unbleavabl/deck-macropad/macropad/LINKS.md

# Links

These links stay the same through future updates: republishing reuses the same URL,
so reload the page to see the newest version. Both are private to the owner's
claude.ai account until shared from the page's Share menu.

| What | Link | Source in this repo |
|---|---|---|
| Wiring diagram (interactive: lid, plate, numbered harness) | https://claude.ai/artifact/4pcYRyfMjdKxRtB2dDA4gZ | `wiring/wiring.html`, built by `wiring/build.py` |
| Build guide (step by step, editable doc) | https://claude.ai/code/artifact/070e5841-1c04-4409-ae30-39a42349cde0 | exported as `build-guide.pdf` |

When asking for an update in a new conversation, pass the link above so the same
page is updated instead of a new one being created.
