unbleavabl/deck-macropad/macropad/case/stickers/stickers.pdf

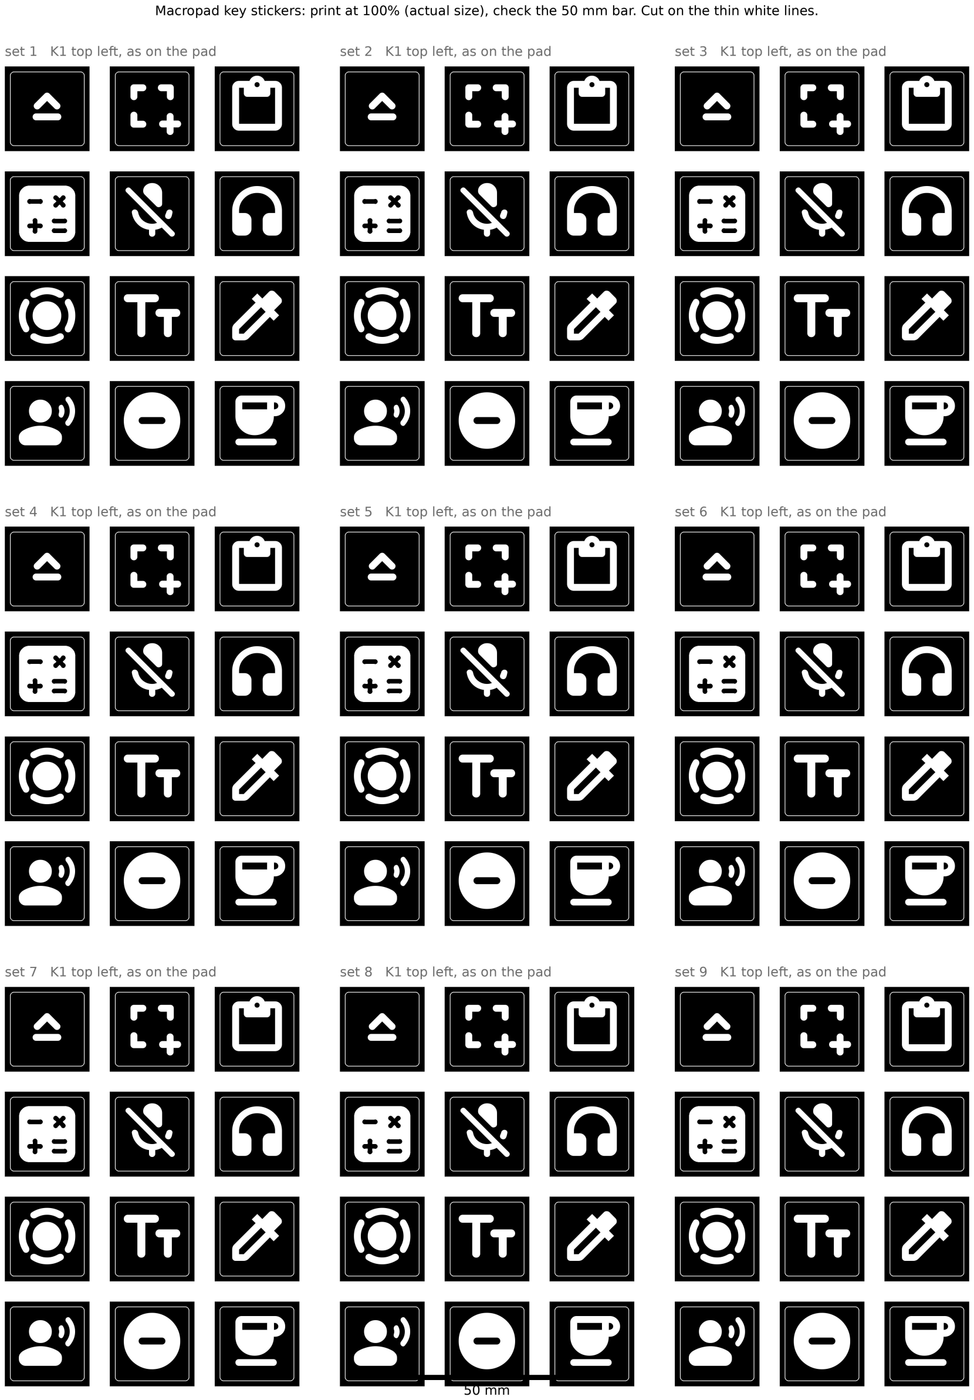
[picture p6: page 1]
