unbleavabl/deck-macropad/macropad/case/stickers/stickers_clear.pdf

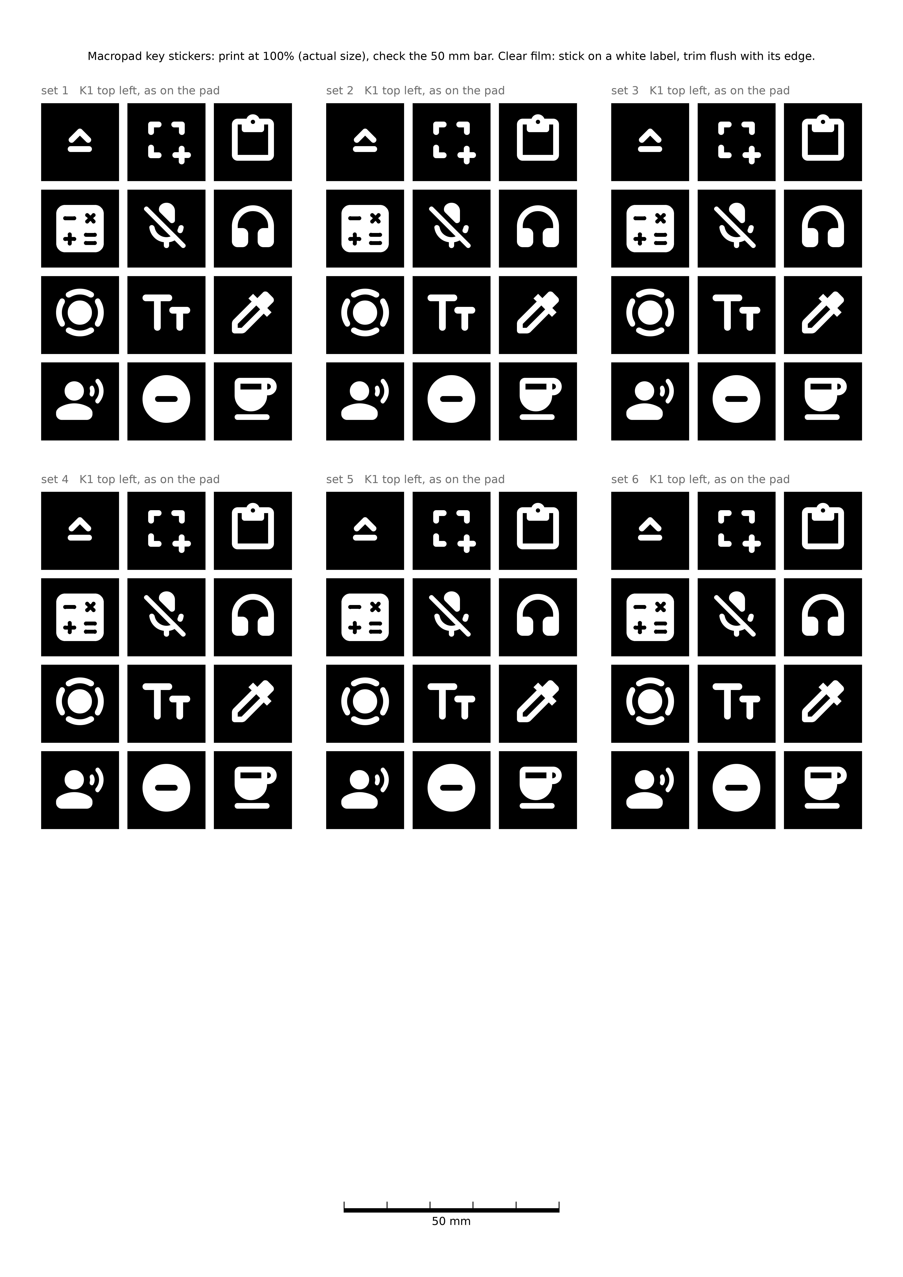
[picture p7: page 1]
