unbleavabl/deck-macropad/macropad/case/preview/combs.png

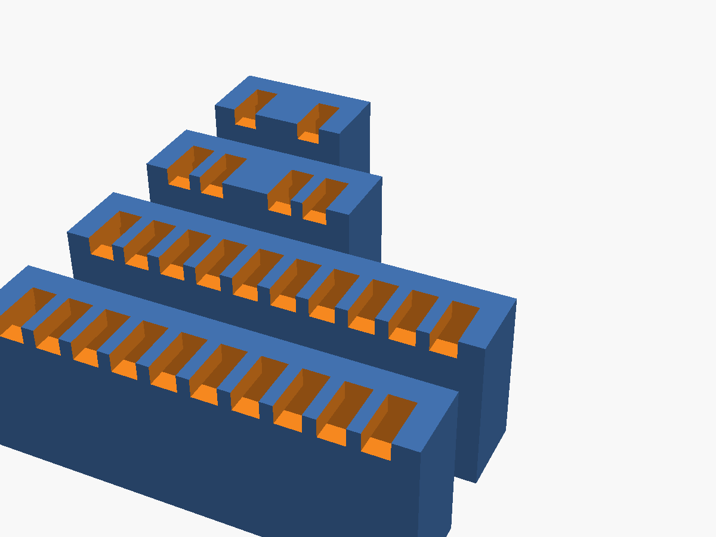
macropad/case/preview/combs.png
