unbleavabl/deck-macropad/macropad/case/preview/deck.png

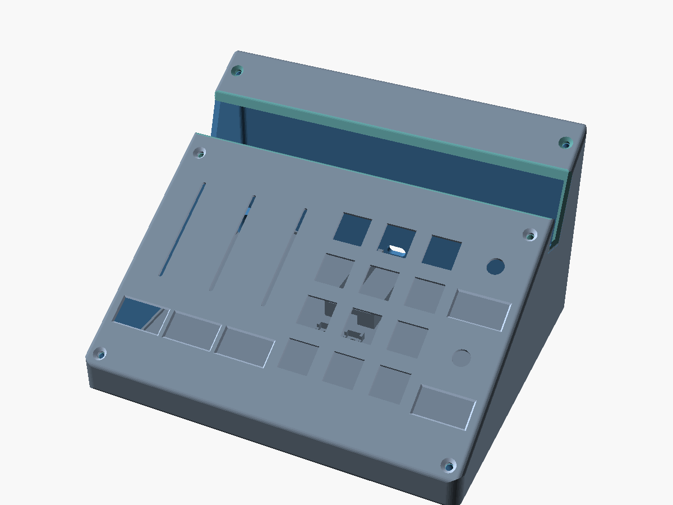
macropad/case/preview/deck.png
