unbleavabl/deck-macropad/macropad/case/preview/deck_back.png

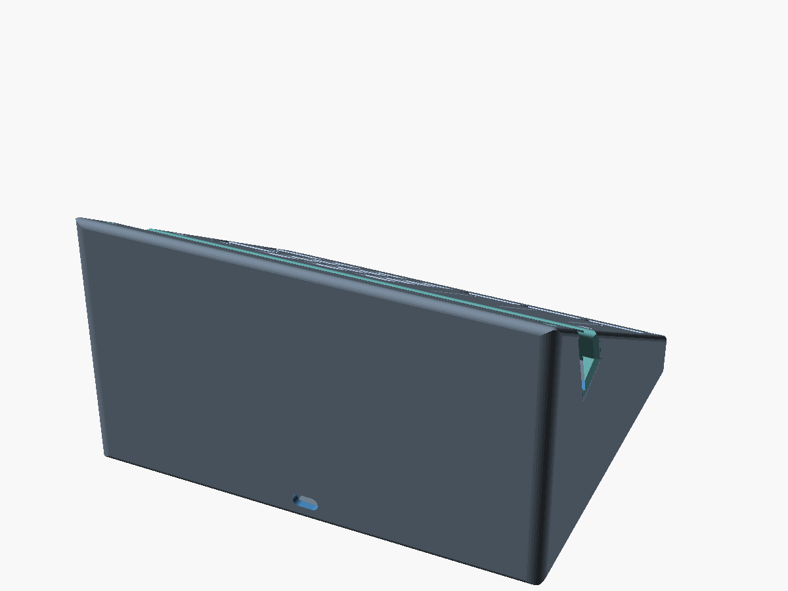
macropad/case/preview/deck_back.png
