unbleavabl/deck-macropad/macropad/case/preview/glue_labels.png

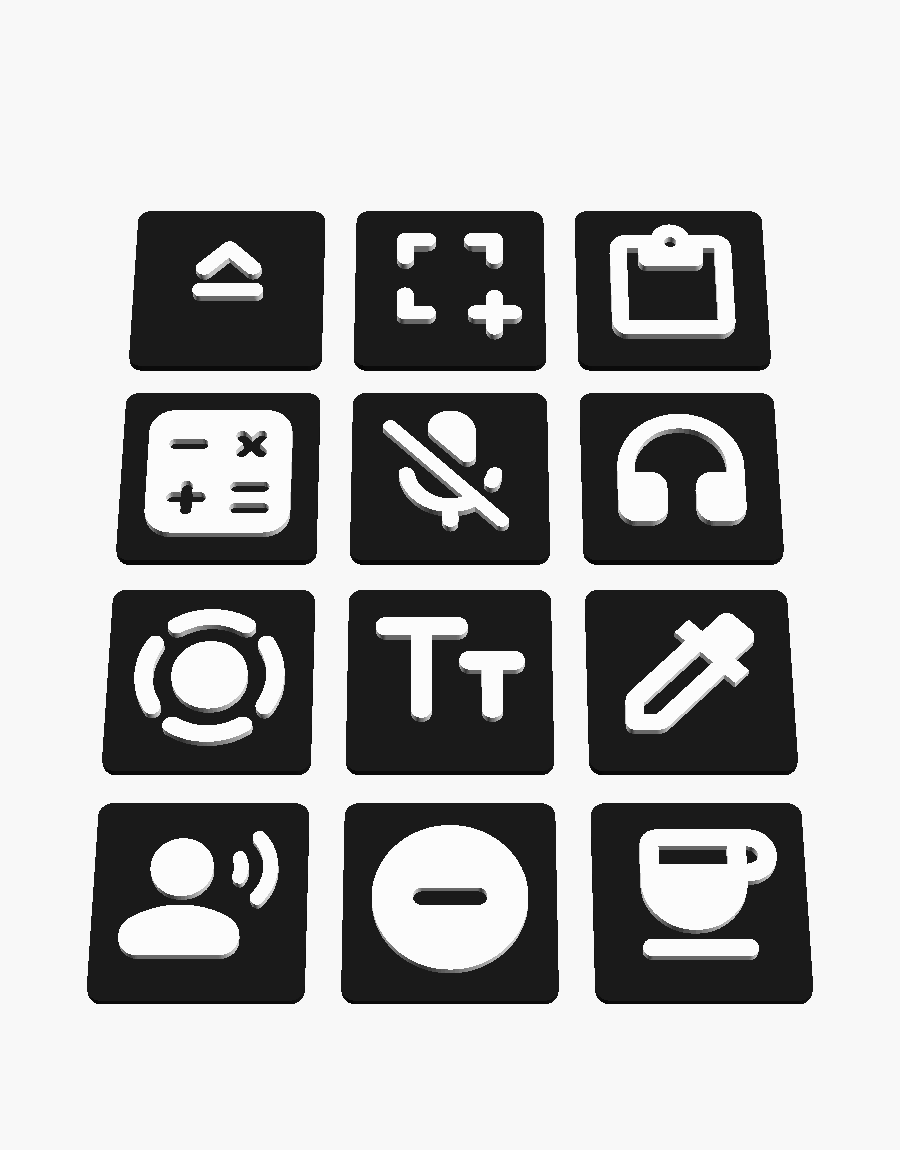
macropad/case/preview/glue_labels.png
