unbleavabl/deck-macropad/macropad/case/preview/keycaps_angle.png

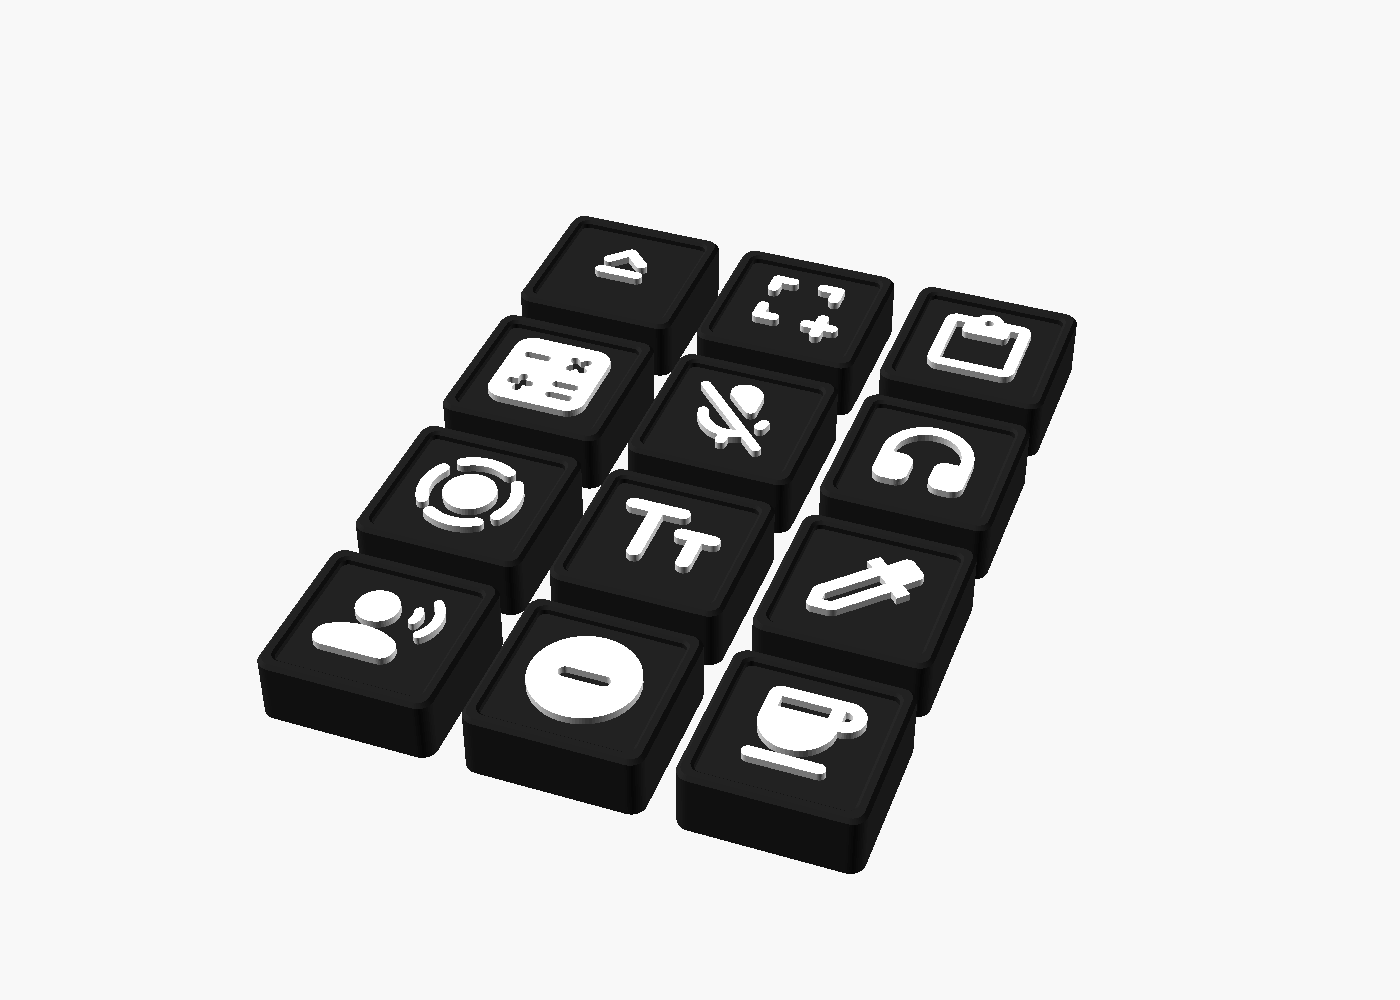
macropad/case/preview/keycaps_angle.png
