unbleavabl/deck-macropad/macropad/case/stickers/stickers.png

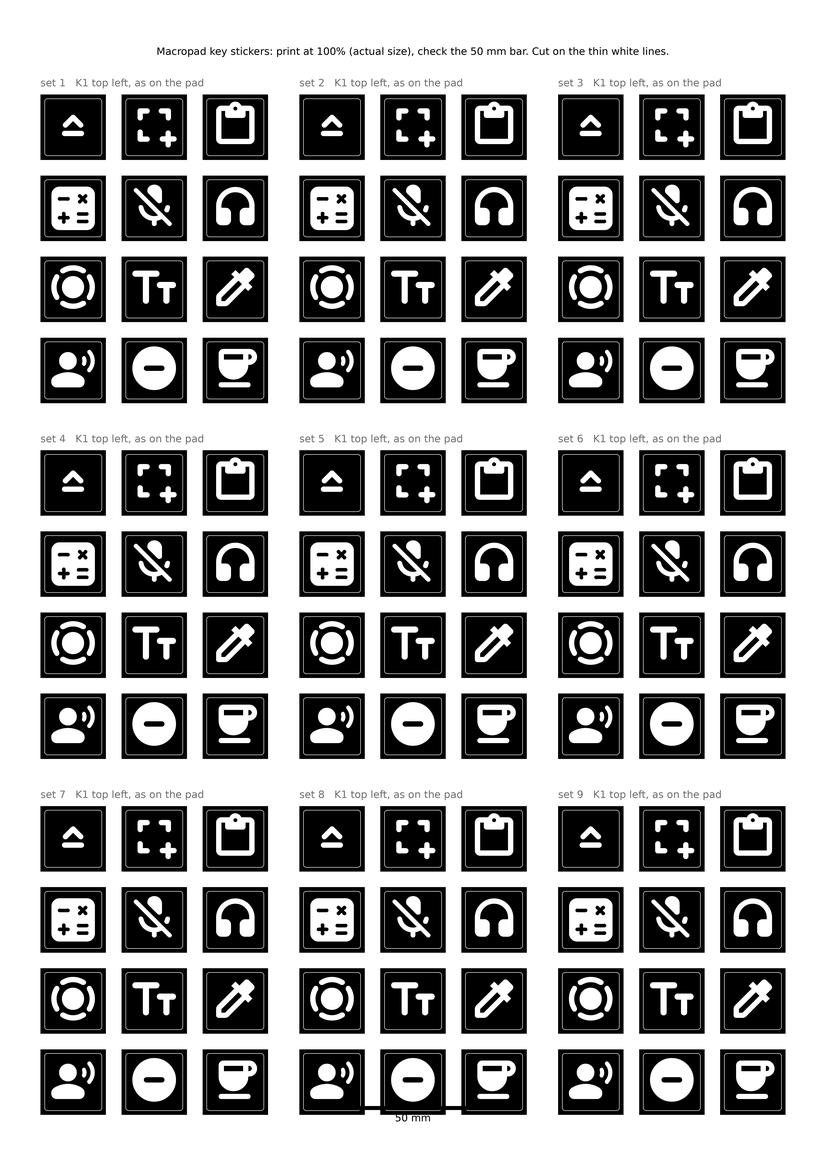
macropad/case/stickers/stickers.png
