unbleavabl/deck-macropad/macropad/case/stickers/text_black.png

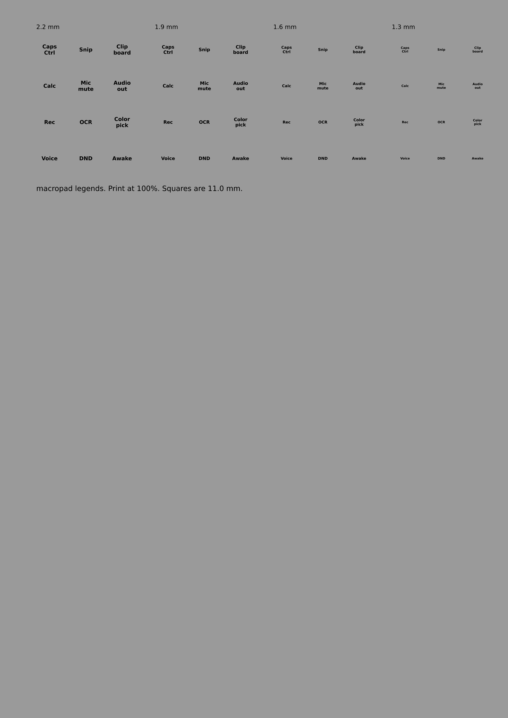
macropad/case/stickers/text_black.png
