unbleavabl/deck-macropad/macropad/case/stickers/text_yellow.png

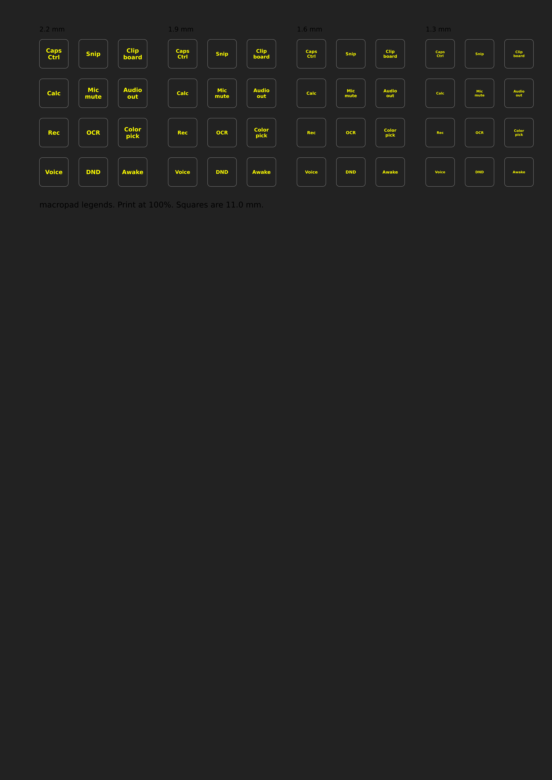
macropad/case/stickers/text_yellow.png
