unbleavabl/deck-macropad/macropad/firmware/layouts-mock-2.png

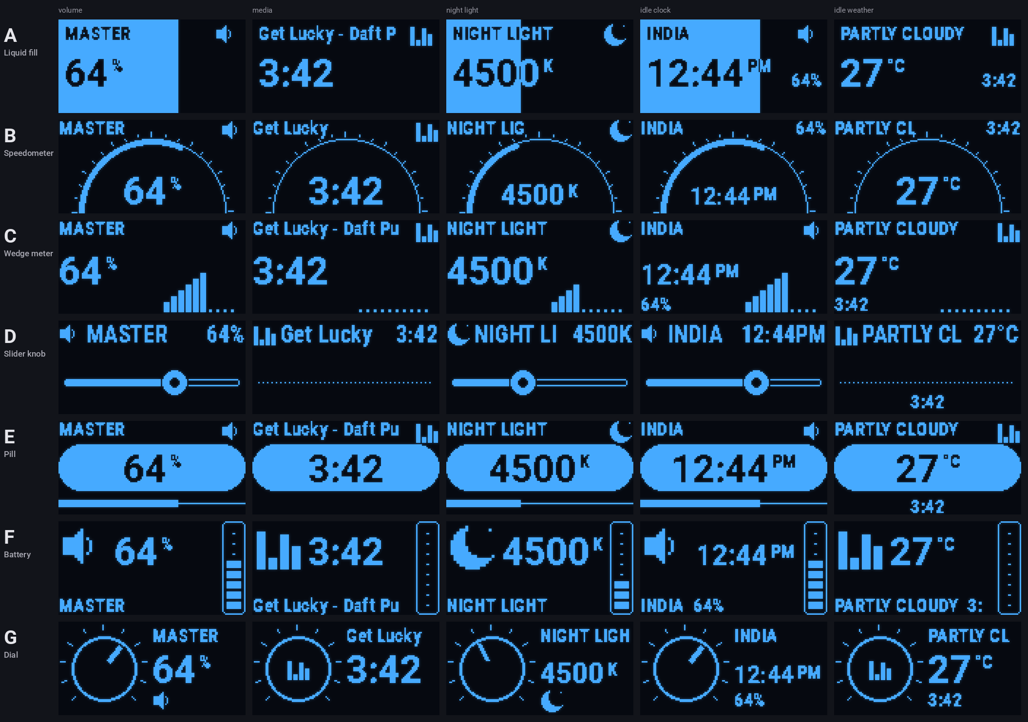
macropad/firmware/layouts-mock-2.png
