unbleavabl/deck-macropad/macropad/firmware/layouts-mock-3.png

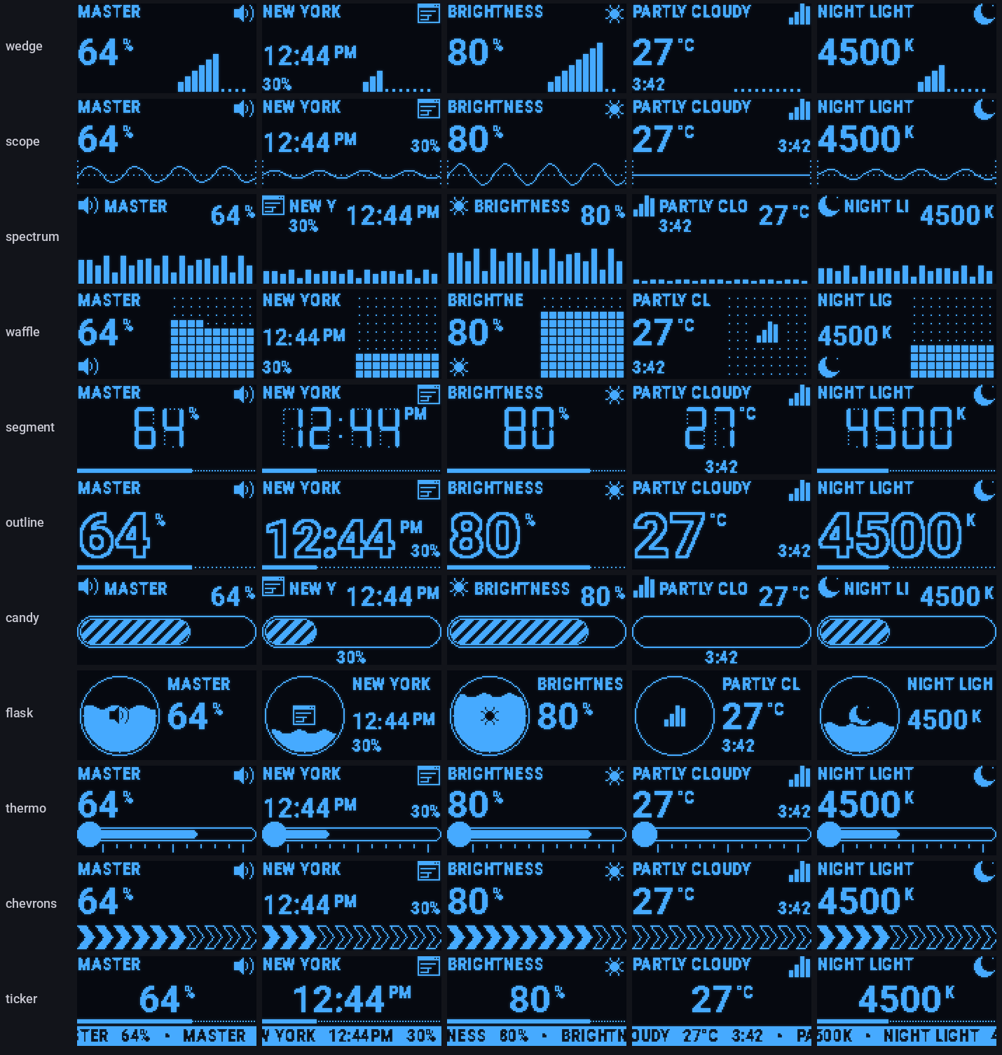
macropad/firmware/layouts-mock-3.png
