unbleavabl/deck-macropad/macropad/firmware/layouts-mock-4.png

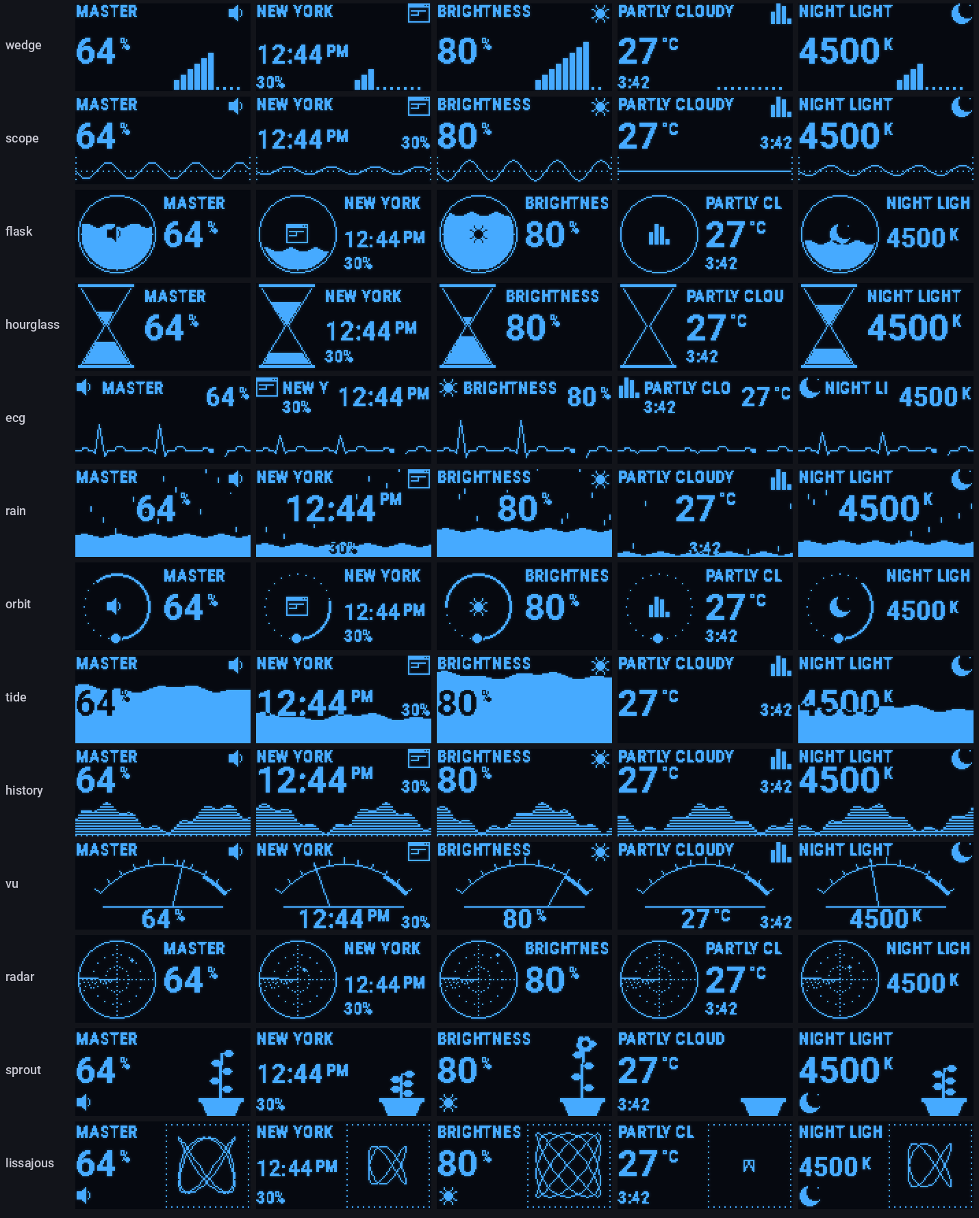
macropad/firmware/layouts-mock-4.png
