unbleavabl/deck-macropad/macropad/firmware/layouts-mock.png

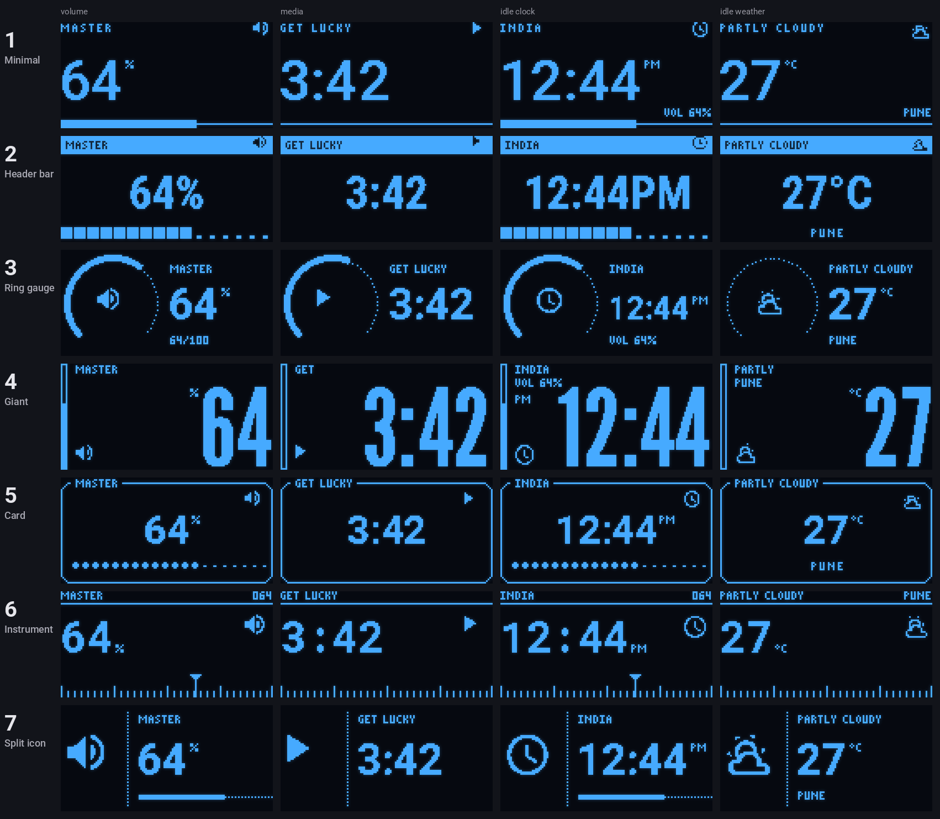
macropad/firmware/layouts-mock.png
