unbleavabl/deck-macropad/macropad/case/preview/parts.png

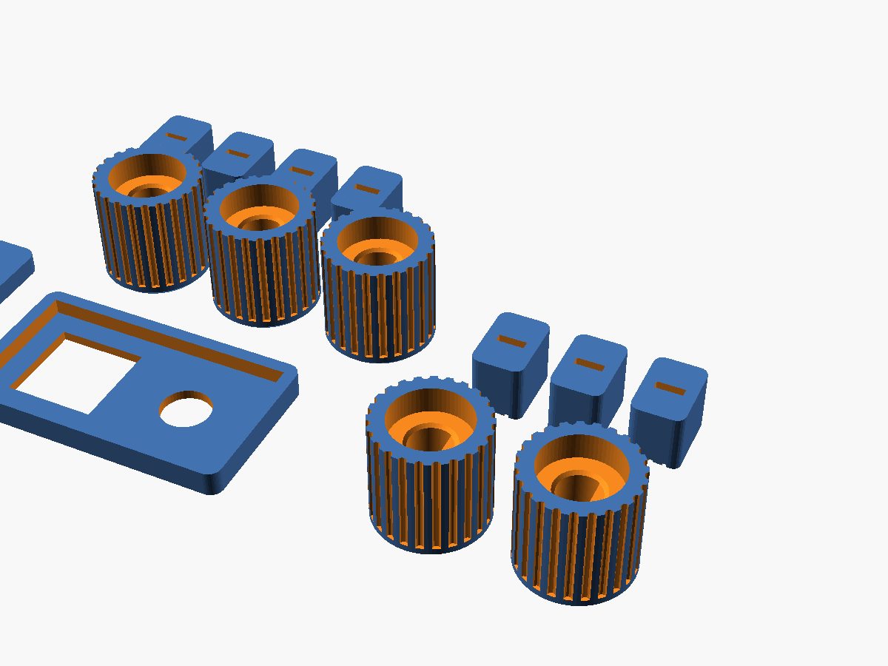
macropad/case/preview/parts.png
