unbleavabl/deck-macropad/macropad/case/3mf/keycaps.3mf

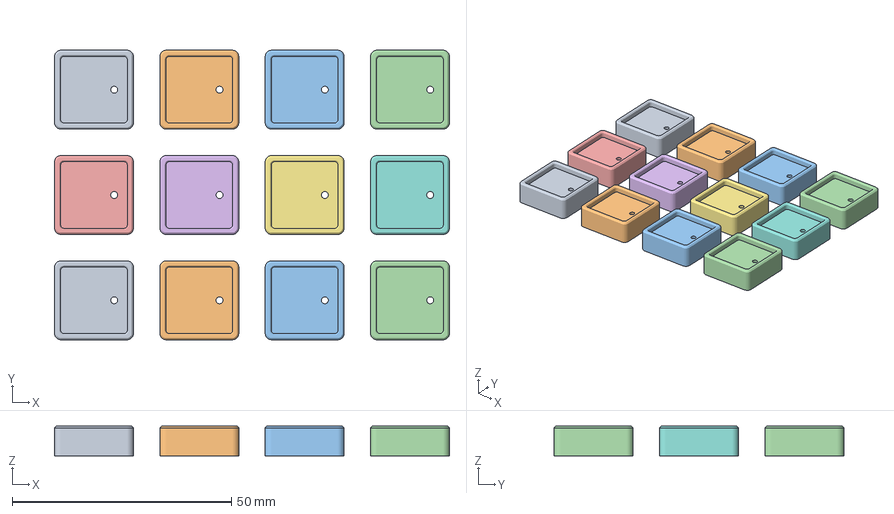
[picture p21: CAD file, 2026-10-14]
macropad/case/3mf/keycaps.3mf
90.0 x 66.0 x 6.80 mm
keycap 1
keycap 2
keycap 3
keycap 4
keycap 5
keycap 6
keycap 7
keycap 8
keycap 9
keycap 10
keycap 11
keycap 12
