unbleavabl/deck-macropad/macropad/case/stl/combs/comb_A.stl

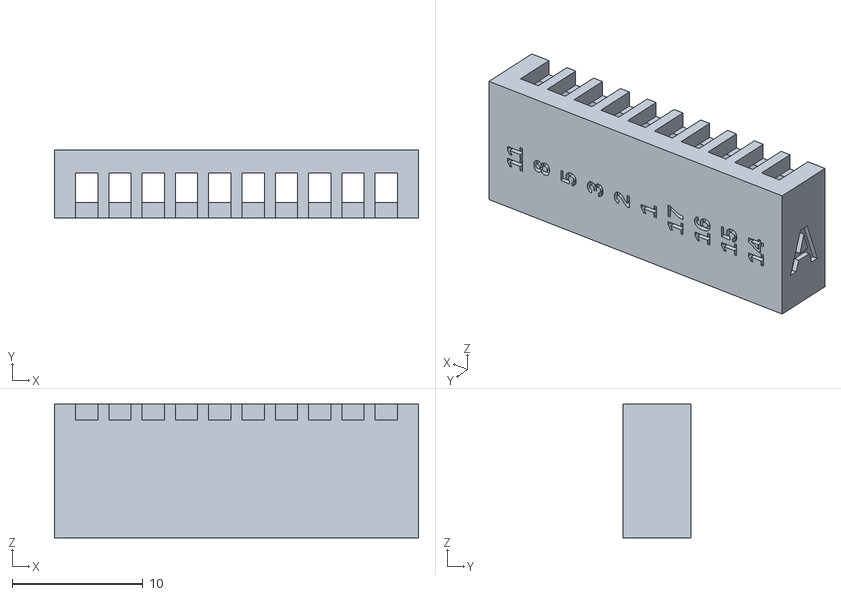
[picture p22: CAD file, 2026-10-14]
macropad/case/stl/combs/comb_A.stl
27.8 x 5.20 x 10.2
