unbleavabl/deck-macropad/macropad/case/stl/deck/deck_frame.stl

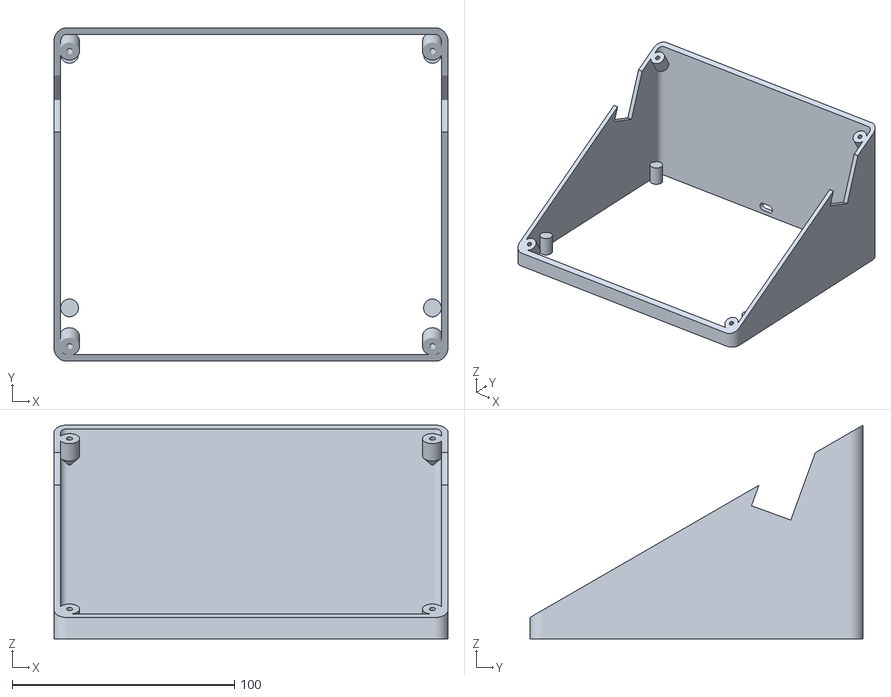
[picture p23: CAD file, 2026-10-14]
macropad/case/stl/deck/deck_frame.stl
177.2 x 150.0 x 96.1
