unbleavabl/deck-macropad/macropad/case/stl/fit-tests/fit_switch_encoder.stl

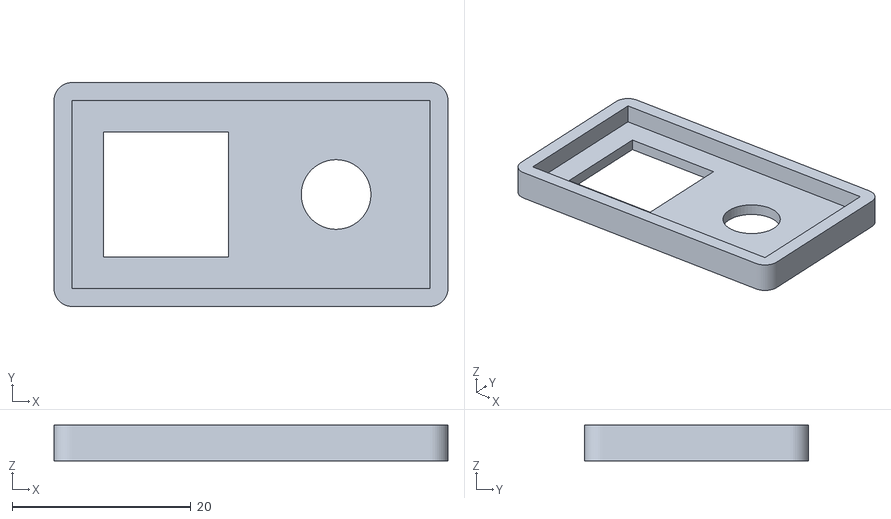
[picture p24: CAD file, 2026-10-14]
macropad/case/stl/fit-tests/fit_switch_encoder.stl
44.1 x 25.1 x 4.00
