unbleavabl/deck-macropad/macropad/case/stl/glue/glue_body.stl

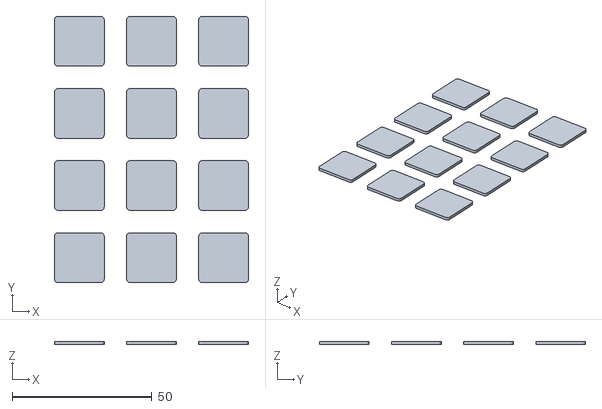
[picture p25: CAD file, 2026-10-14]
macropad/case/stl/glue/glue_body.stl
69.4 x 95.2 x 1.20
