unbleavabl/deck-macropad/macropad/case/stl/keycaps/keycap.stl

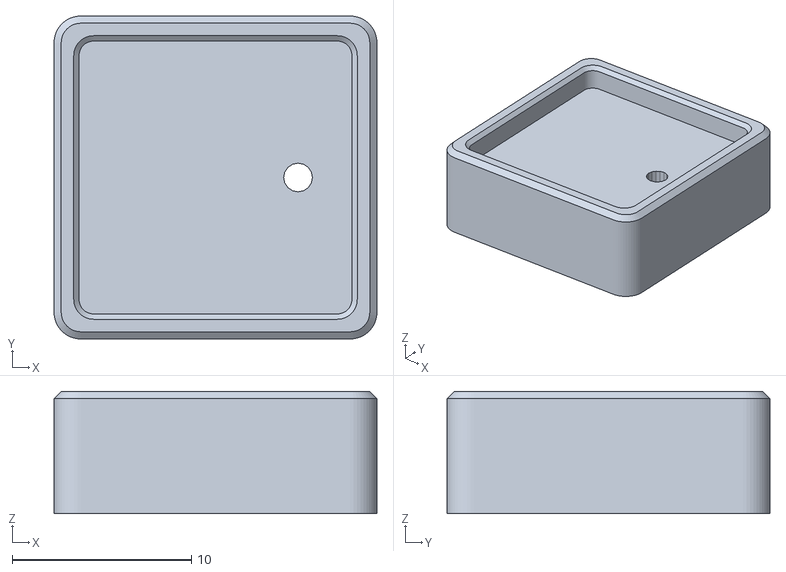
[picture p26: CAD file, 2026-10-14]
macropad/case/stl/keycaps/keycap.stl
18.0 x 18.0 x 6.80
