unbleavabl/deck-macropad/macropad/case/stl/knobs-caps/knob.stl

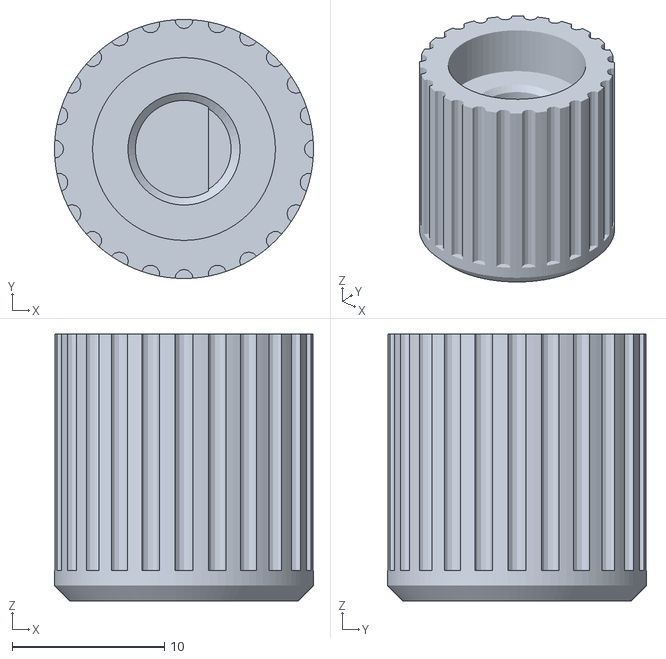
[picture p27: CAD file, 2026-10-14]
macropad/case/stl/knobs-caps/knob.stl
17.0 x 17.0 x 17.5
