unbleavabl/deck-macropad/macropad/case/3mf/fit_keycap_caps.3mf

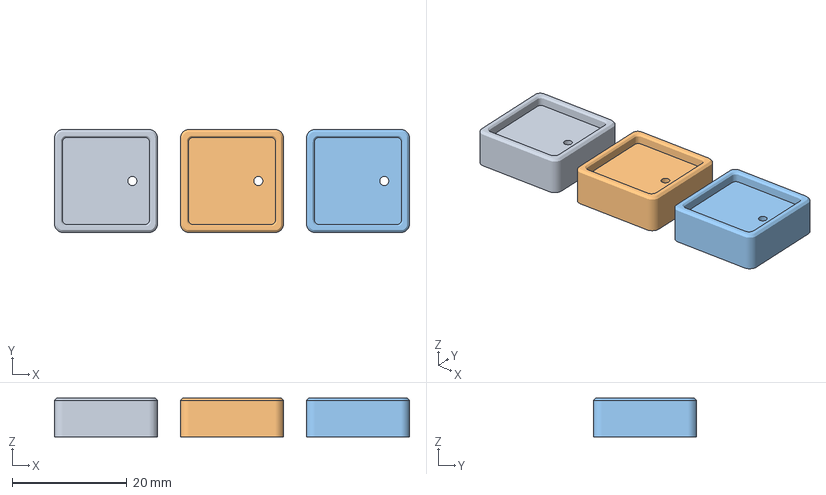
[picture p28: CAD file, 2026-10-14]
macropad/case/3mf/fit_keycap_caps.3mf
62.0 x 18.0 x 6.80 mm
cap 1 dot cross 4.0 x 1.2
cap 2 dots cross 4.1 x 1.3
cap 3 dots cross 4.2 x 1.4
