unbleavabl/deck-macropad/macropad/case/stl/combs/comb_C.stl

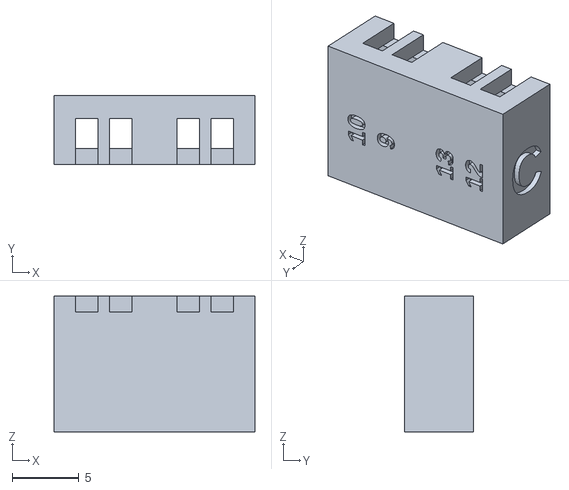
[picture p29: CAD file, 2026-10-14]
macropad/case/stl/combs/comb_C.stl
15.1 x 5.20 x 10.2
