unbleavabl/deck-macropad/macropad/case/stl/deck/deck_plate.stl

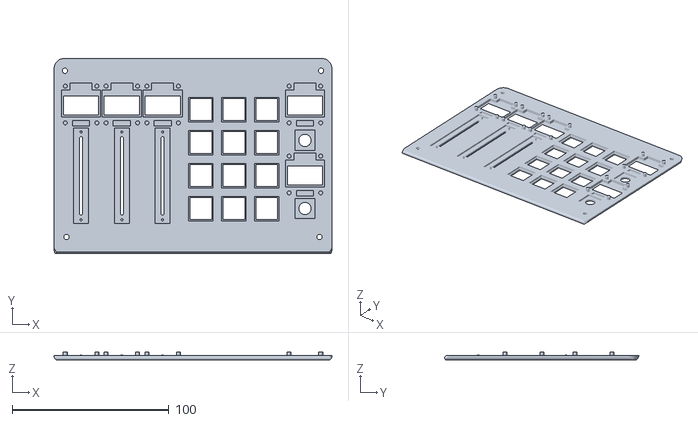
[picture p30: CAD file, 2026-10-14]
macropad/case/stl/deck/deck_plate.stl
177.2 x 124.1 x 5.38
