unbleavabl/deck-macropad/macropad/case/stl/fit-tests/fit_keycap_labels.stl

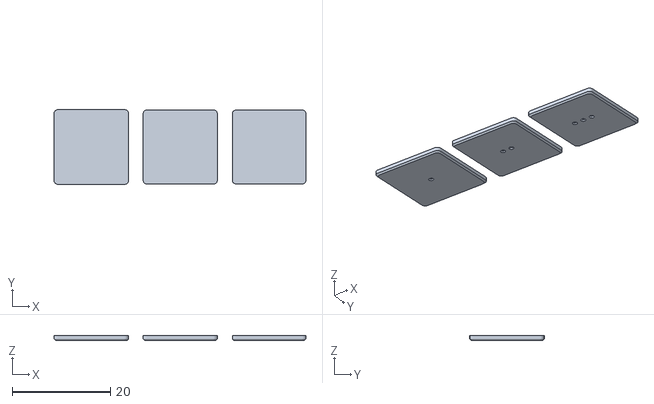
[picture p31: CAD file, 2026-10-14]
macropad/case/stl/fit-tests/fit_keycap_labels.stl
51.3 x 15.2 x 1.00
