unbleavabl/deck-macropad/macropad/case/stl/glue/glue_legend.stl

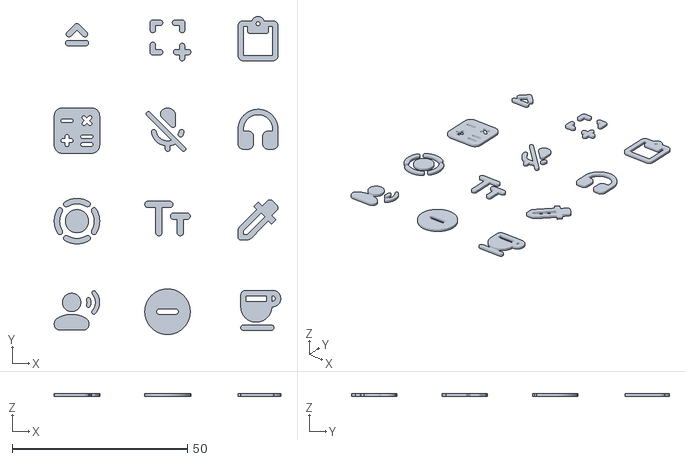
[picture p32: CAD file, 2026-10-14]
macropad/case/stl/glue/glue_legend.stl
64.6 x 90.6 x 0.8
