unbleavabl/deck-macropad/macropad/case/stl/keycaps/label_legend.stl

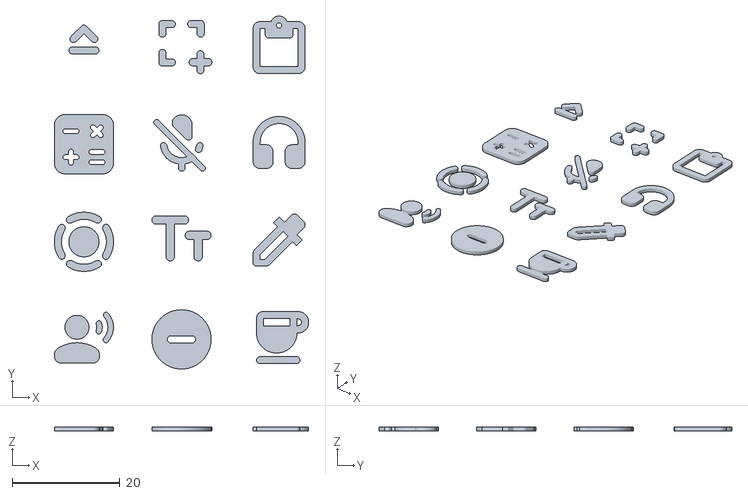
[picture p33: CAD file, 2026-10-14]
macropad/case/stl/keycaps/label_legend.stl
47.2 x 65.5 x 0.8
