unbleavabl/deck-macropad/macropad/case/stl/knobs-caps/enc_spacer.stl

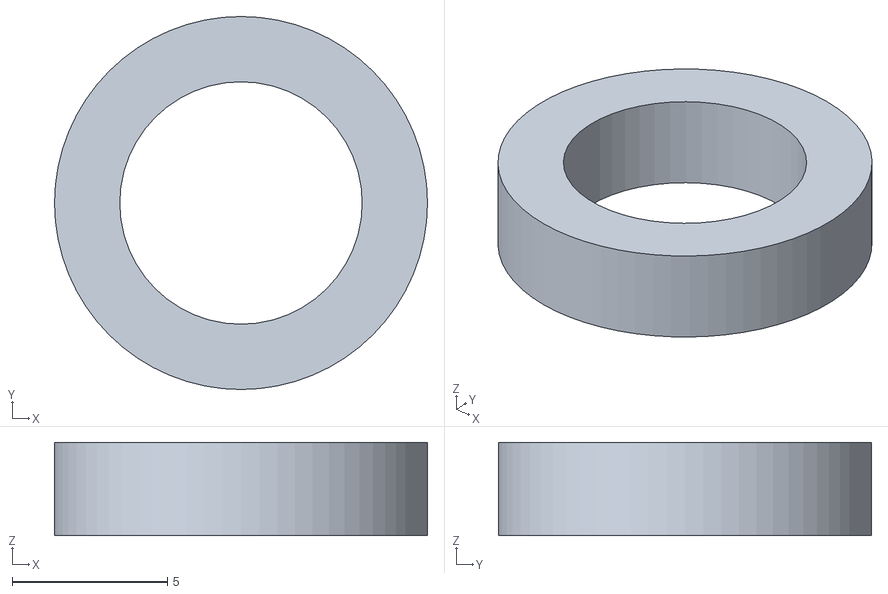
[picture p34: CAD file, 2026-10-14]
macropad/case/stl/knobs-caps/enc_spacer.stl
12.0 x 12.0 x 3.00
