unbleavabl/deck-macropad/macropad/case/3mf/labels.3mf

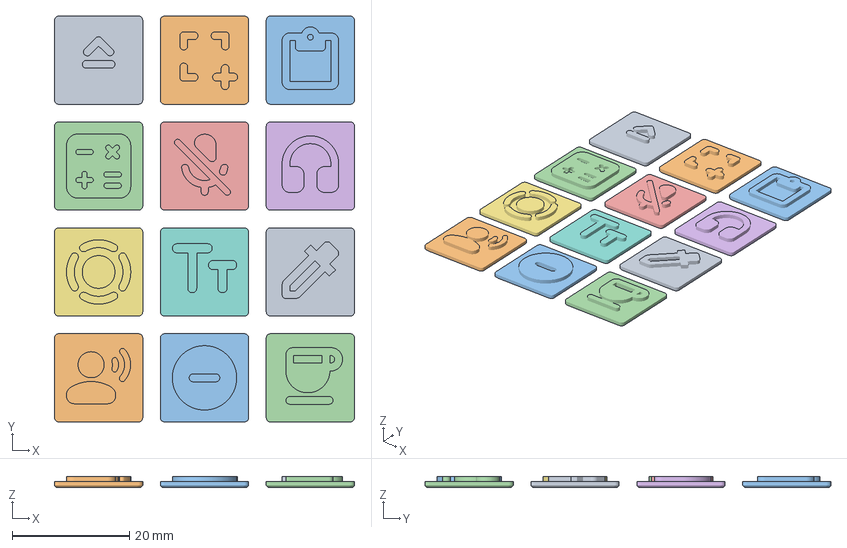
[picture p35: CAD file, 2026-10-14]
macropad/case/3mf/labels.3mf
51.3 x 69.4 x 1.80 mm
K1 label
K2 label
K3 label
K4 label
K5 label
K6 label
K7 label
K8 label
K9 label
K10 label
K11 label
K12 label
