unbleavabl/deck-macropad/macropad/case/stl/deck/deck_dock.stl

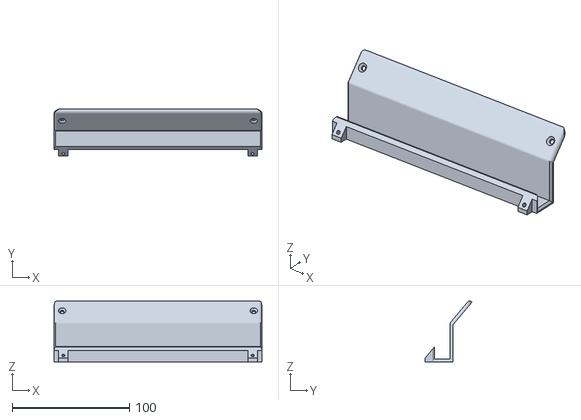
[picture p36: CAD file, 2026-10-14]
macropad/case/stl/deck/deck_dock.stl
177.2 x 40.1 x 51.9
