unbleavabl/deck-macropad/macropad/case/stl/fit-tests/fit_knob.stl

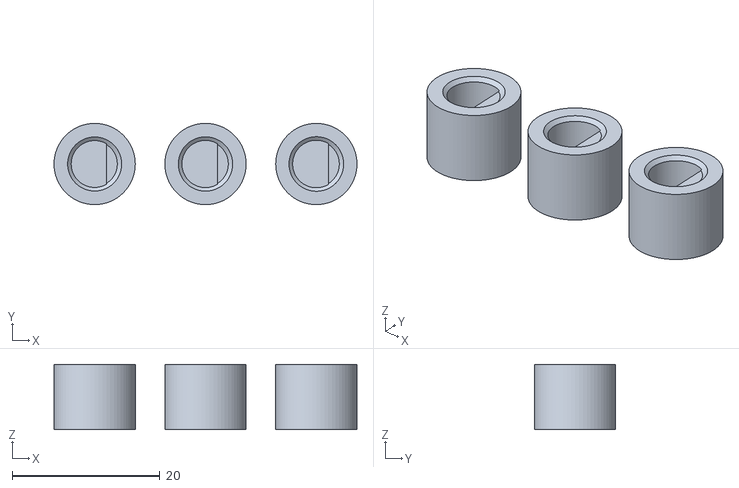
[picture p37: CAD file, 2026-10-14]
macropad/case/stl/fit-tests/fit_knob.stl
41.0 x 11.0 x 8.80
