unbleavabl/deck-macropad/macropad/case/stl/keycaps/label_body.stl

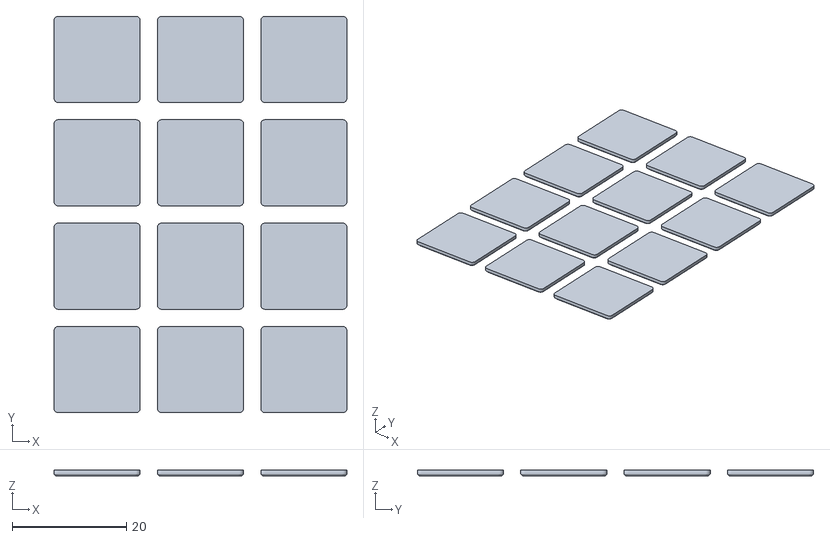
[picture p38: CAD file, 2026-10-14]
macropad/case/stl/keycaps/label_body.stl
51.3 x 69.4 x 1.00
