unbleavabl/deck-macropad/macropad/case/stl/knobs-caps/fader_cap.stl

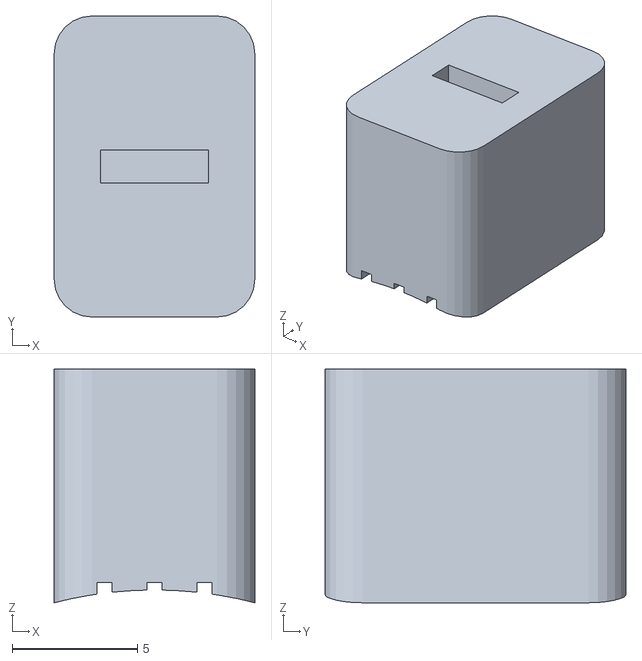
[picture p39: CAD file, 2026-10-14]
macropad/case/stl/knobs-caps/fader_cap.stl
8.00 x 12.0 x 9.31
