unbleavabl/deck-macropad/macropad/case/3mf/fit_keycap_labels.3mf

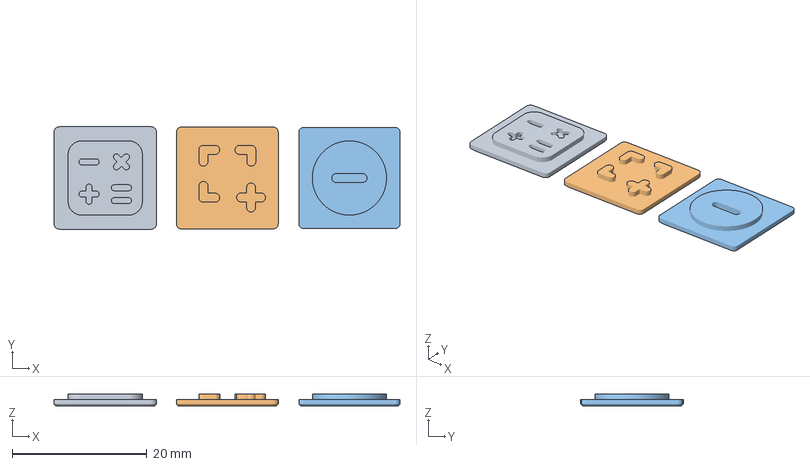
[picture p40: CAD file, 2026-10-14]
macropad/case/3mf/fit_keycap_labels.3mf
51.3 x 15.2 x 1.80 mm
label 1 dot clearance 0.00
label 2 dots clearance 0.05
label 3 dots clearance 0.10
