unbleavabl/deck-macropad/macropad/case/stl/combs/fit_comb.stl

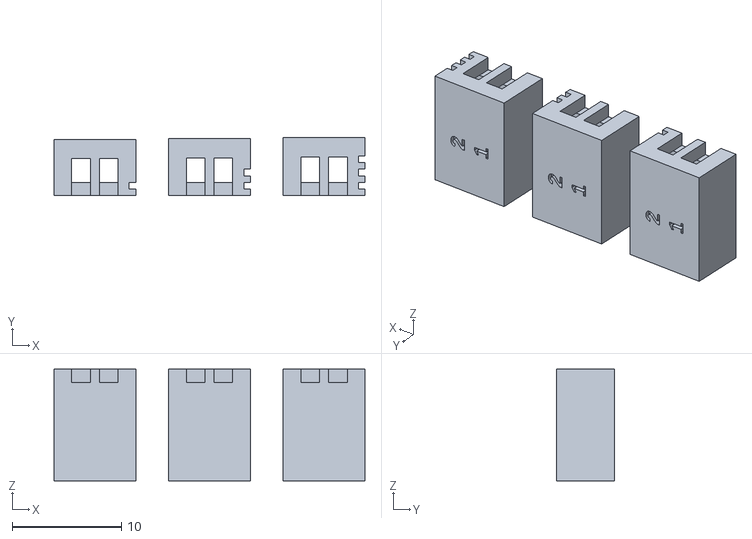
[picture p41: CAD file, 2026-10-14]
macropad/case/stl/combs/fit_comb.stl
28.4 x 5.30 x 10.2
