unbleavabl/deck-macropad/macropad/case/stl/deck/deck_lid.stl

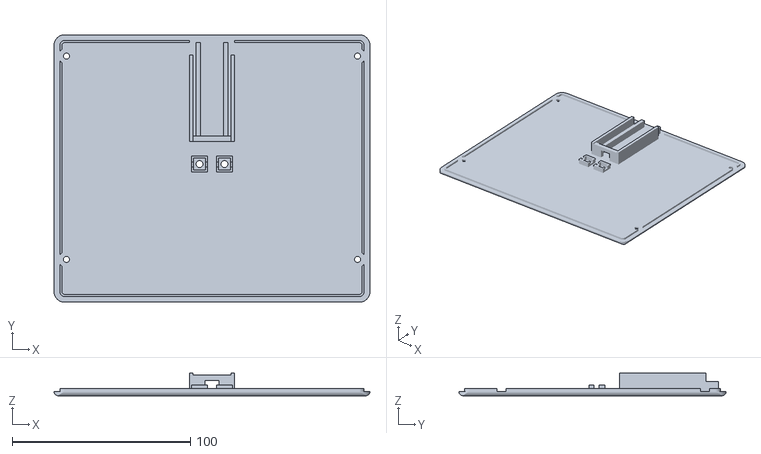
[picture p42: CAD file, 2026-10-14]
macropad/case/stl/deck/deck_lid.stl
177.2 x 150.0 x 12.7
