unbleavabl/deck-macropad/macropad/case/stl/fit-tests/fit_knob_caps.stl

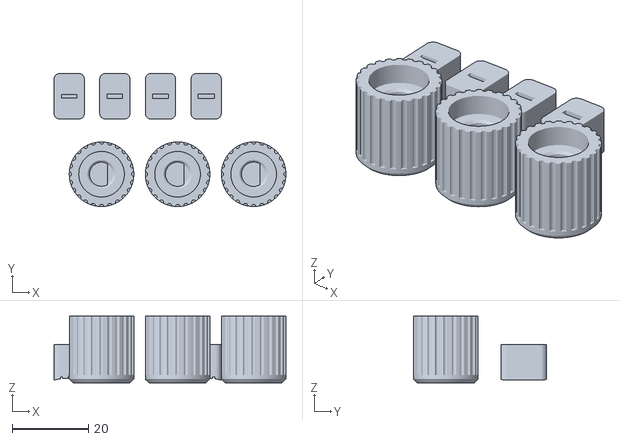
[picture p43: CAD file, 2026-10-14]
macropad/case/stl/fit-tests/fit_knob_caps.stl
61.0 x 35.0 x 17.5
