unbleavabl/deck-macropad/macropad/case/stl/keycaps/label_blank.stl

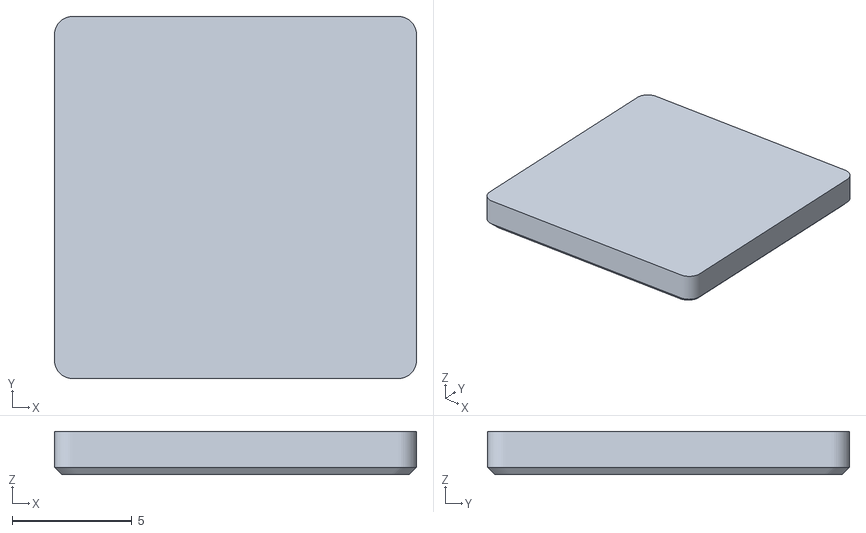
[picture p44: CAD file, 2026-10-14]
macropad/case/stl/keycaps/label_blank.stl
15.1 x 15.1 x 1.80
