unbleavabl/deck-macropad/macropad/case/3mf/glue_labels.3mf

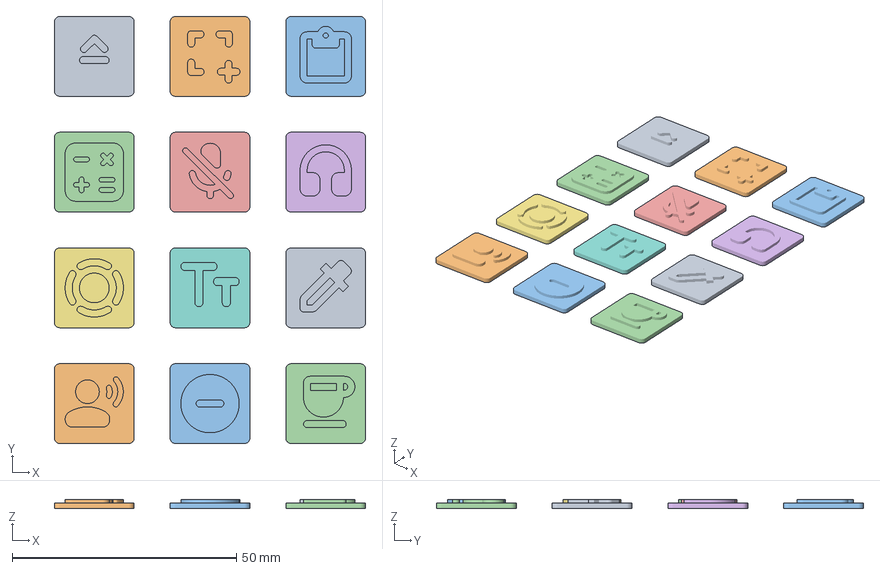
[picture p45: CAD file, 2026-10-14]
macropad/case/3mf/glue_labels.3mf
69.4 x 95.2 x 2.00 mm
K1 glue label
K2 glue label
K3 glue label
K4 glue label
K5 glue label
K6 glue label
K7 glue label
K8 glue label
K9 glue label
K10 glue label
K11 glue label
K12 glue label
