unbleavabl/deck-macropad/macropad/case/stl/combs/comb_D.stl

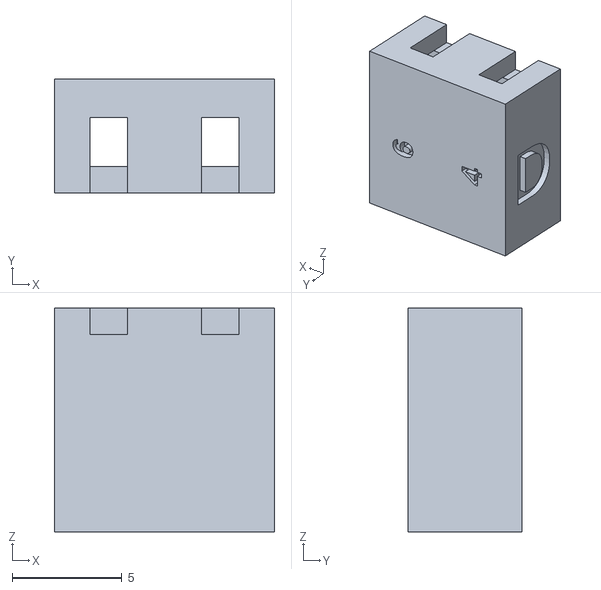
[picture p46: CAD file, 2026-10-14]
macropad/case/stl/combs/comb_D.stl
10.0 x 5.20 x 10.2
