unbleavabl/deck-macropad/macropad/case/stl/fit-tests/fit_keycap_legend.stl

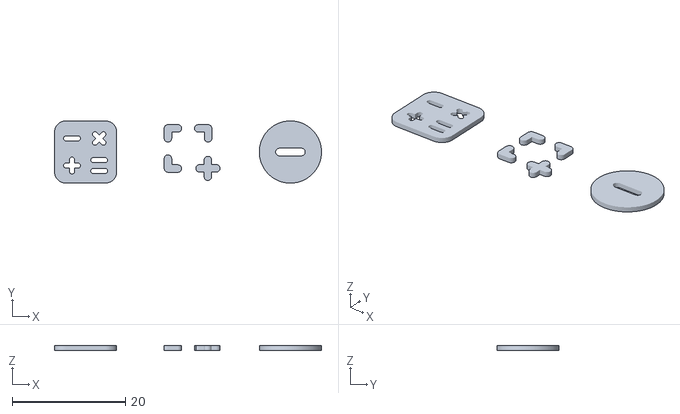
[picture p47: CAD file, 2026-10-14]
macropad/case/stl/fit-tests/fit_keycap_legend.stl
47.2 x 11.0 x 0.8
