unbleavabl/deck-macropad/macropad/case/3mf/labels_blank_white.3mf

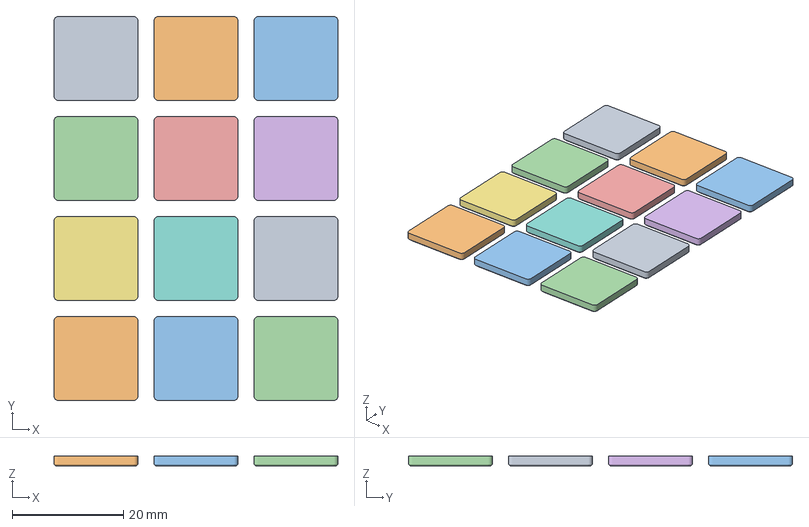
[picture p48: CAD file, 2026-10-14]
macropad/case/3mf/labels_blank_white.3mf
51.1 x 69.1 x 1.80 mm
blank label 1
blank label 2
blank label 3
blank label 4
blank label 5
blank label 6
blank label 7
blank label 8
blank label 9
blank label 10
blank label 11
blank label 12
