unbleavabl/deck-macropad/macropad/case/stl/fit-tests/fit_screen.stl

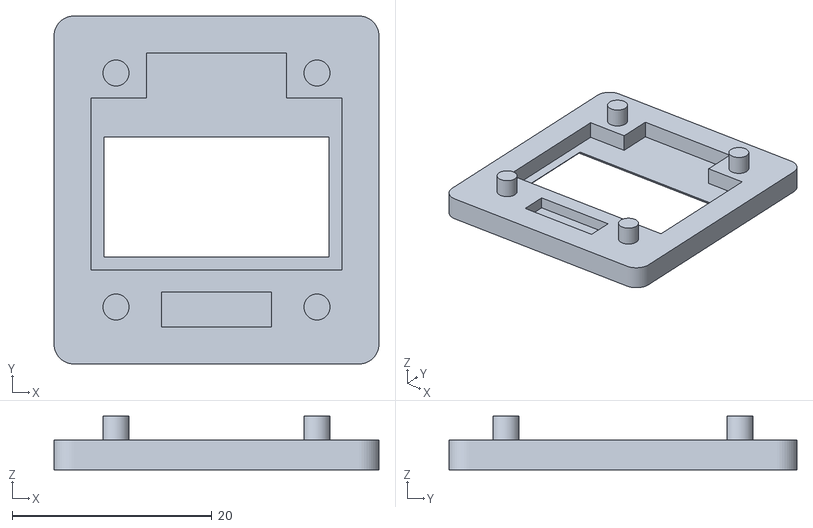
[picture p49: CAD file, 2026-10-14]
macropad/case/stl/fit-tests/fit_screen.stl
32.5 x 34.8 x 5.40
