unbleavabl/deck-macropad/macropad/case/stl/fit-tests/fit_bp_cradle.stl

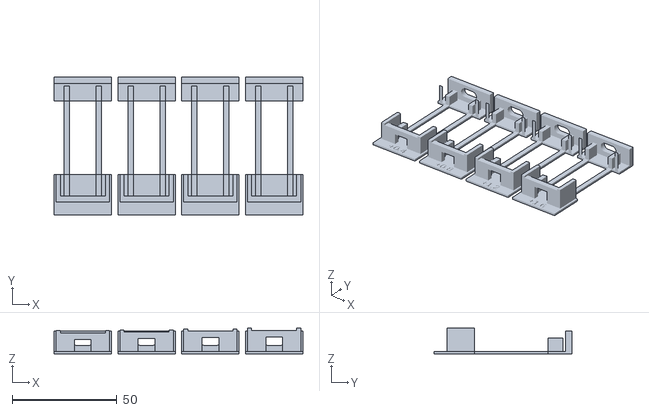
[picture p50: CAD file, 2026-10-14]
macropad/case/stl/fit-tests/fit_bp_cradle.stl
119.0 x 65.8 x 12.2
