unbleavabl/deck-macropad/(list of files, cad)

Other CAD files:
macropad/case/stl/combs/comb_B.stl
macropad/case/stl/fit-tests/fit_keycap_caps.stl
