unbleavabl/deck-macropad/macropad/wiring/wiring.html

Handwired · no PCB · tilted deck

# Macropad Wiring

12 × MX2 × EC113 × slide pot5 × 0.96" SSD1306 (I2C, via TCA9548A)STM32F411 BlackPill · QMK4 × 4 matrix, col2row14 × 1N4148USB-C only

- Thick line: bare copper bus
- Thin line: insulated jumper
- Sleeve where two buses cross
- 9Same number at both ends of a wire
- Rows
- Columns
- Encoder A / B
- Slider pin 2
- Screen wires
- 3V3
- Ground (G)
- Buttons

The wiring

## Lid above, plate below, to scale

Lay the case out like this while you wire: the lid inside-up at the top, the plate upside down below it, their back edges together. The plate carries the bare copper buses (thick lines: one per row, one per column, a GND and a 3V3 loop) and short insulated jumpers from every part to them. The lid holds the BlackPill, the multiplexer and the two buttons. The 27 wires between them are soldered at the plate end, gather along the plate's back edge into five flat ribbons, and end in five multi-pin Dupont plugs, A to E, on male header pins on the BlackPill and the multiplexer, so the lid unplugs. Each wire's number is on its line in the fold band and in the table below: tape it at both ends. Mark pin 1 of each plug and its header so it only goes on one way.

Click or hover a number, part or bus. Pick a number, part or bus to see only its wires. Hide finished wires Zoom in

Thin wires that cross without a dot don't touch: they're insulated. Bare copper only crosses bare copper under a sleeve (grey block). Dots are solder joints. The plate is seen from below, so K1 is at the top right, the sliders on the right and the knob column on the left; the lid lies turned round, USB-C toward the fold. Both halves are to the same scale and line up: a point in the lid sits over the plate point straight below it when the case is closed. Check the pin numbers printed on your sliders and screens: the drawing shows them from the back.

Harness

## The 27 wires between plate and lid

One row per wire, in number order. Hover a row to see that wire in the drawing; click it to keep it picked. Tick each one off once its plate end is soldered and its plug is on its pin.

Clear ticks

Wire | On the plate | In the lid | Done
Between plate and lid
1 | Row 0 bus, its end by column 0 | A4 · plug A
2 | Row 1 bus, its end by column 0 | A5 · plug A
3 | Row 2 bus, its end by column 0 | A6 · plug A
4 | Row 3 bus, its end by column 0 | B14 · plug D
5 | Column 0 bus, its back end | A7 · plug A
6 | Column 1 bus, its back end | A8 · plug D
7 | Column 2 bus, its back end | A15 · plug E
8 | Column 3 wire (knob pushes), at the wall by E2 | B0 · plug A
9 | GND bus, its back end by slider 3 | G · plug C
10 | 3V3 bus, its back end by slider 3 | 3V3 · plug C
11 | E1 pin A | B1 · plug A
12 | E1 pin B | B8 · plug C
13 | E2 pin A | B9 · plug C
14 | E2 pin B | A0 · plug A
15 | Slider 1 pin 2 | A1 · plug A
16 | Slider 2 pin 2 | A2 · plug A
17 | Slider 3 pin 2 | A3 · plug A
18 | S1 SDA | mux SD0 · plug B
19 | S1 SCL | mux SC0 · plug B
20 | S2 SDA | mux SD1 · plug B
21 | S2 SCL | mux SC1 · plug B
22 | S3 SDA | mux SD2 · plug B
23 | S3 SCL | mux SC2 · plug B
24 | S4 SDA | mux SD3 · plug B
25 | S4 SCL | mux SC3 · plug B
26 | S5 SDA | mux SD4 · plug B
27 | S5 SCL | mux SC4 · plug B
Inside the lid
L1 | Mux SCL | B6
L2 | Mux SDA | B7
L3 | Mux GND | G (right-hand header, USB end)
L4 | Mux VIN | 3V3 (right-hand header, USB end)
L5 | B button, both legs | the board's own BOOT0 button, two legs (solder before the board goes in)
L6 | R button, both legs | R and G (right-hand header; G shared with L3)

+−Fit

How each part connects

## Buses, parts and the lid

### Buses

Bare solid copper, laid first and soldered at every joint: one wire per row and per column across the keys, and a GND and a 3V3 pair twice: across the front, just in front of the screens, and across the slider ends, joined by two insulated wires up the slider-side edge. Bare copper never crosses a circuit board. Where two buses cross, slide a piece of sleeve or heat-shrink over the upper one: bare copper on bare copper shorts. Each bus takes one numbered wire to its BlackPill pin.

### Keys

The switch pin nearer the front sits on its column bus: solder it straight on. The other pin takes the diode's plain red end; the black band end goes to the row bus.

### Knobs

Push pins: the one nearer the keys takes a diode to row 0 (E2) or row 2 (E1); the other joins column 3, an insulated wire up the knob-column wall from E1 to E2. C: a short jumper to the GND pin of the knob's own screen. A and B: numbered wires up the wall to the BlackPill, no diode.

### Sliders

Pins 1 and 2 are at the back end, pin 3 alone at the front end. Pin 1 to the 3V3 bus across the slider ends; pin 3 by a short jumper to the GND pin of the slider's own screen, just in front of it. Pin 2 is a numbered wire to A1, A2 or A3, with a 100 nF capacitor standing beside the slider body, on its right as you look at it from the back: one leg to pin 2 by a short jumper, the other leg to the GND bus across the slider ends. The capacitor has no polarity.

### Screens

4-pin I2C modules (SDA, SCL, GND, VCC, left to right from the back), all at the same address. VCC and GND by jumpers down to the front pair; S5's run down the gap between the keys and the knob column. SDA and SCL are a numbered pair to the screen's channel on the multiplexer: S1 on SD0 and SC0, up to S5 on SD4 and SC4. S1 to S3 run up between the sliders, S4 and S5 up the wall.

### Lid

BlackPill upside down in its cradle (chips down, USB-C at the back), multiplexer glued right of it seen from above, both with male header pins, long side up, so the numbered wires plug straight on. Solder L5 to the board's own BOOT0 button before the board goes in. Mux VIN to 3V3, GND to G, SDA to B7, SCL to B6; leave A0 to A2 and RST unconnected (address 0x70). Power everything from 3V3 only.

Every diode in these drawings is drawn like this: red body, black band, just like the real 1N4148. The black band always faces the row bus. Turn the diode around and that key stops working.

Close-up

## One encoder up close

An EC11 takes the place of a key. A printed 3 mm spacer ring on its bushing makes it sit lower, so the shaft doesn't stand too tall above the plate. The nut goes on from the top, without its washer.

Snip off or bend flat the small anti-rotation tab next to the bushing first. If the nut can't catch the thread, hot-glue the ring to the plate and the encoder to the ring instead.

Seen from below, the same way as the plate in the main drawing. Turn the encoder so the 3-pin side faces the front, toward the screens. The two encoders are wired the same way; only the column and the BlackPill pins for A and B differ. If a knob turns the wrong way, swap the two keycodes on that knob in the keymap and leave the wires alone.

Pin reference

## BlackPill pins and the buttons

Seen from above as it sits in the lid cradle: upside down, chips and the board's own buttons facing the lid, back side up, USB-C pointing at the back wall. The male header strips go in from the chip side, so the long pins stick up out of the back and the short ends sit on the cradle rails; the pin names are printed next to each hole: check them before plugging each wire on.

20 pins used. G and 3V3 each have two pads; use either. Leave the grey ones alone: A9 senses USB and A10 can stop USB loading, A11 and A12 are the USB lines, B2 is BOOT1, C13 drives the LED, C14 and C15 hold a crystal. BOOT0 has no pin hole, so the B button is wired across the board's own BOOT0 button: find two of its legs that beep only while it is pressed, and solder both wires on before the board goes into the cradle, since the button ends up underneath. A0 also has the board's KEY button on it, which is fine. If your board has the small 8-pin flash chip fitted on the back, A4 to A7 are taken: tell me before wiring.

Build order

## Wiring checklist

0 of 11 done Clear ticks

1. PlateSwitches clipped in; encoders with spacer ring and nut; sliders and screens pegged and glued
2. BusesColumn buses: bare copper along each key column, front-row pin to back-row pin, switch pins soldered on
3. BusesRow buses: bare copper across each key row, rows 0 and 2 on into the gap by the knobs; sleeve every crossing
4. BusesGND and 3V3 pairs: across the front (in front of the screens) and across the slider ends; 2 insulated links up the slider side
5. KeysDiode from each key's free pin to its row bus, black band at the bus
6. KnobsPush: diode from the pin nearer the keys to row 0 (E2) or row 2 (E1) · column 3 wire up the wall, E1 to E2 · C: to its screen's GND pin
7. SlidersPins 1 and 2 at the back end, pin 3 at the front · pin 1 → 3V3 back bus · pin 3 → its screen's GND pin · 100 nF right of the slider body (from the back): one leg to pin 2, the other to the GND back bus
8. ScreensVCC → 3V3 · GND → GND, jumpers down to the front pair; S5's down the gap by the keys
9. LidMale header pins on the BlackPill and multiplexer (long pins up); L5 soldered to the BlackPill's BOOT0 button; BlackPill upside down in its cradle (chips down, USB-C at the back), multiplexer glued right of it, B and R buttons in their pockets
10. LidLid wires L1–L6: mux to BlackPill, and the two buttons (harness table)
11. HarnessWires 1–27: soldered at the plate end, gathered into ribbons A–E along the back edge, crimped into plugs A–E (harness table)

Before closing the case

## Test with a meter, USB unplugged

1. Beep setting, probes on 3V3 and G: it must not beep.
2. Diode setting, red probe on the column pin, black on the row pin, for example A7 and A4 for K1. Press: about 0.5–0.7 V. Release: nothing. Repeat for all 14 positions: 12 keys and both knob pushes.
3. A reading with the key released means that row and column touch somewhere. Nothing when pressed usually means a diode is in backwards.
4. Knobs: beep setting between B1 and G; turning knob 1 clicks it on and off. Same for B8, then B9 and A0 for knob 2.
5. Sliders: resistance setting between A1 and G; moving slider 1 runs it smoothly from 0 to about 10 kΩ. Same for A2 and A3.
6. Screens: beep each screen's VCC to 3V3 and GND to G. Its SDA and SCL beep only with its own mux channel pads (S1 SD0 and SC0, and so on).
7. Buses: beep each row bus against each column bus with no key pressed: none may beep. If one does, a sleeve has slipped at that crossing.
