unbleavabl/deck-macropad/macropad/wiring/harness-side-preview.png

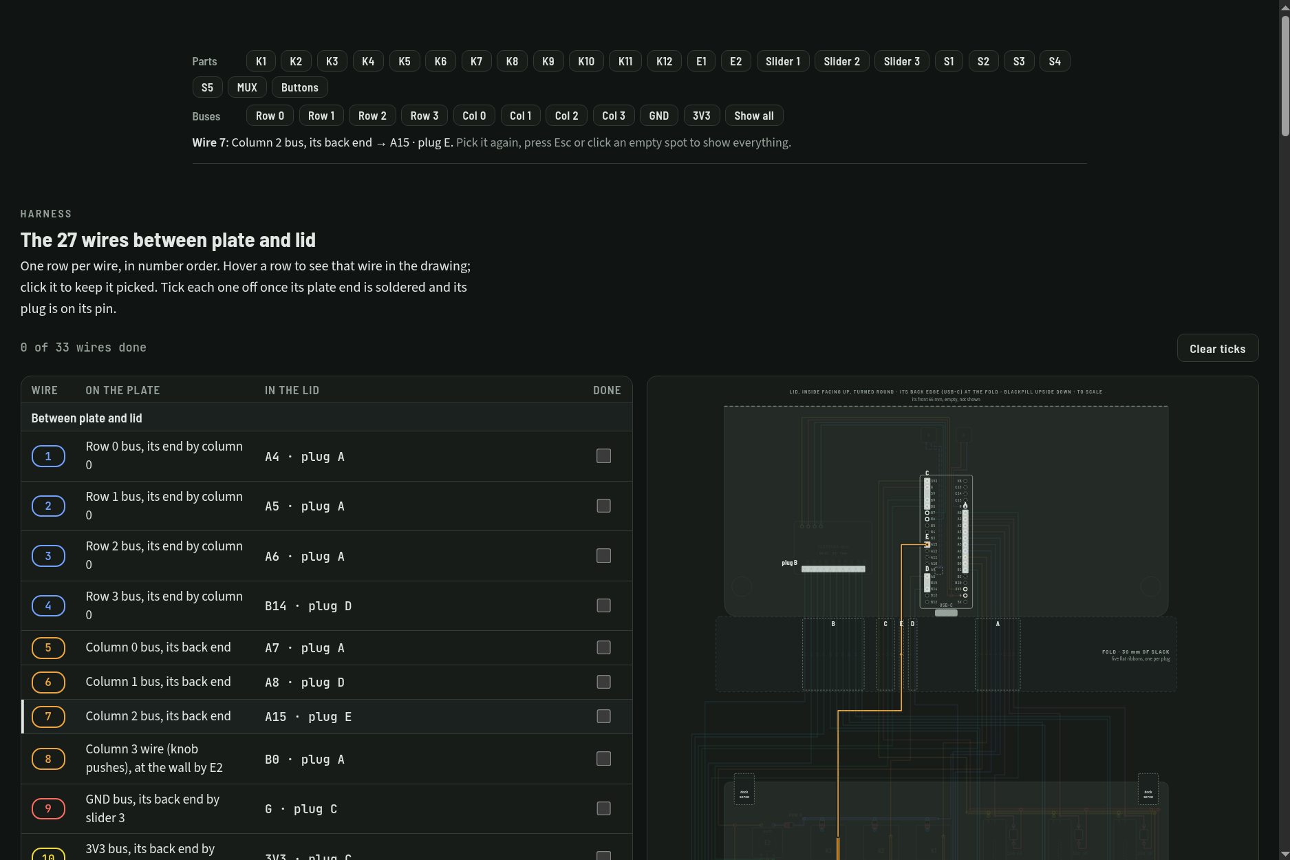
macropad/wiring/harness-side-preview.png
