unbleavabl/deck-macropad/macropad/wiring/img/lid_and_ribbons.png

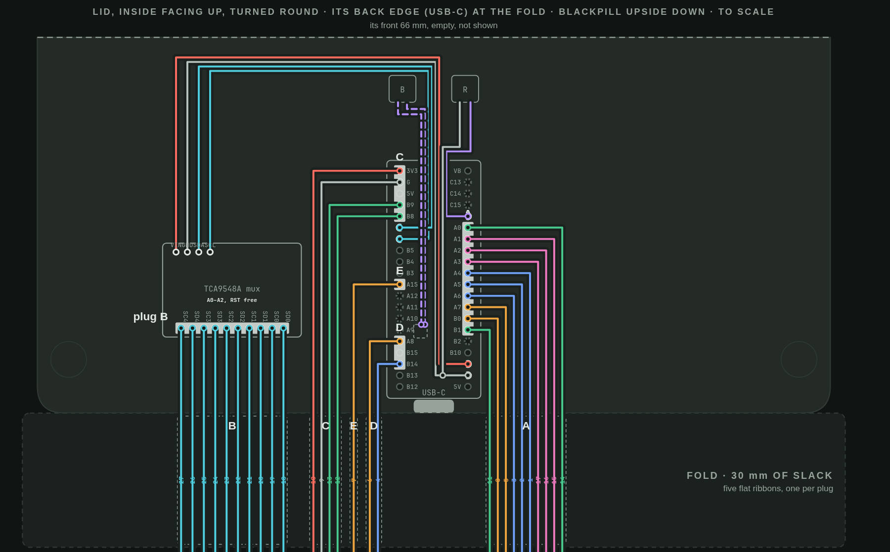
macropad/wiring/img/lid_and_ribbons.png
