unbleavabl/deck-macropad/macropad/wiring/img/whole_case.png

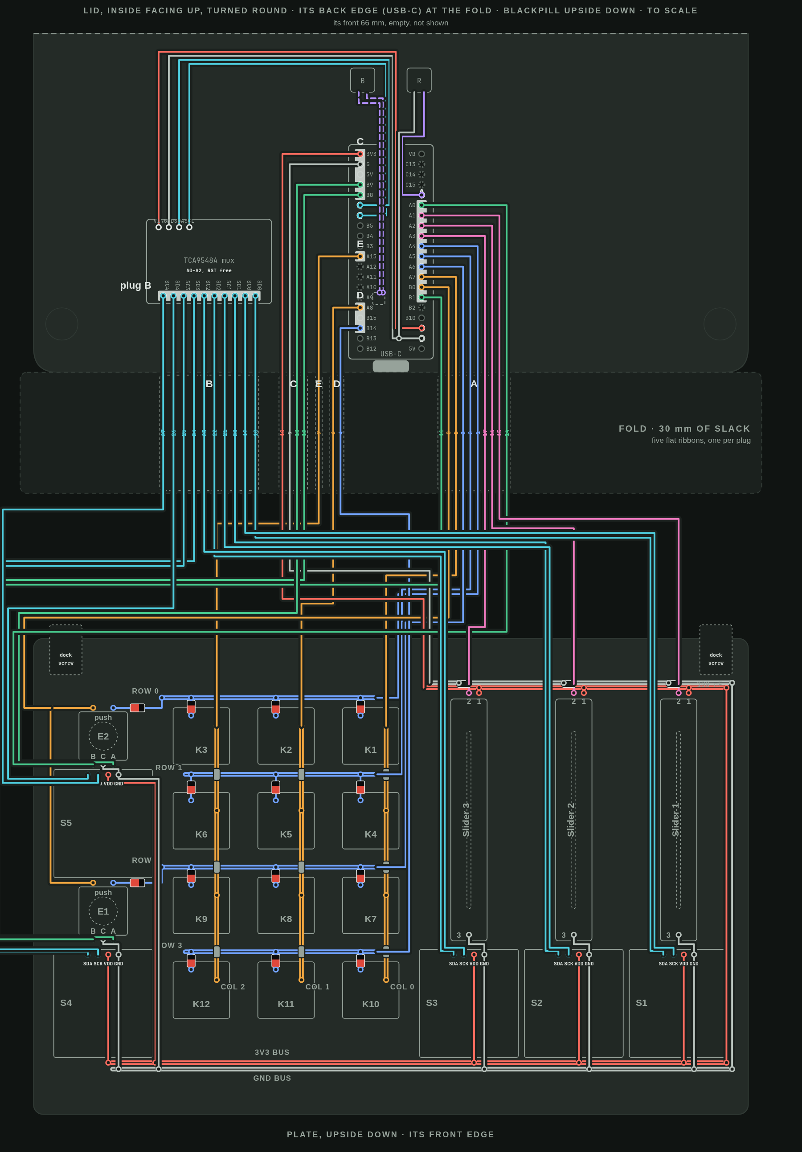
macropad/wiring/img/whole_case.png
