unbleavabl/deck-macropad/macropad/case/stickers/text_black.pdf

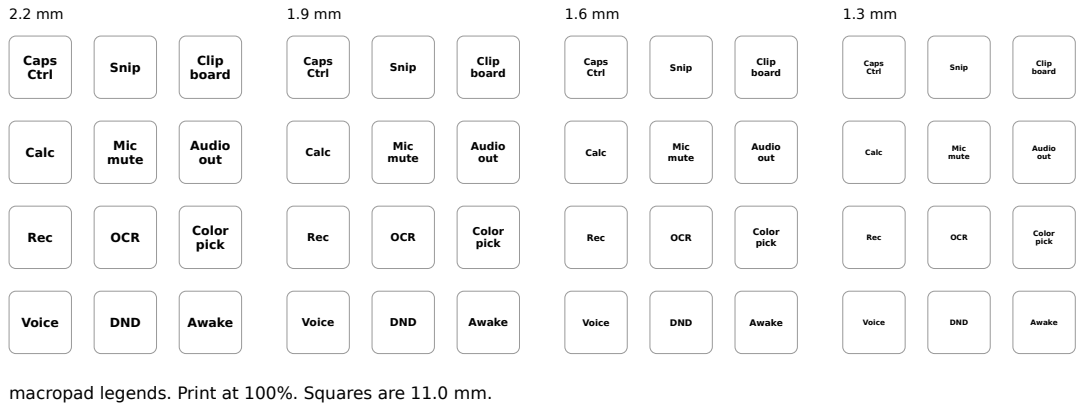
[picture p63: page 1]
Caps; Ctrl; Snip; Clip; board; Calc; Mic; mute; Audio out; Rec; OCR; Color; pick; Voice; DND; Awake

macropad legends. Print at 100%. Squares are 11.0 mm.
