unbleavabl/deck-macropad/macropad/pcb/fit-check-1to1.pdf

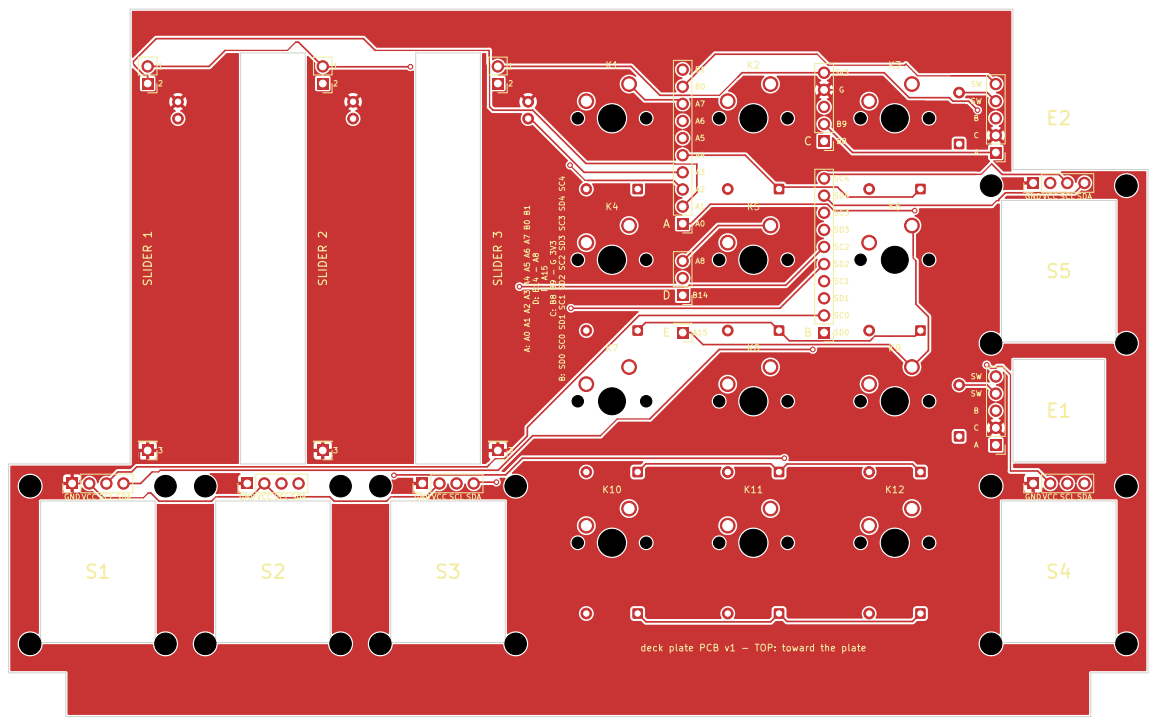
[picture p64: page 1]
