unbleavabl/deck-macropad/macropad/pcb/deck.kicad_pcb

## KiCad design macropad/pcb/deck.kicad_pcb (2026-10-14)

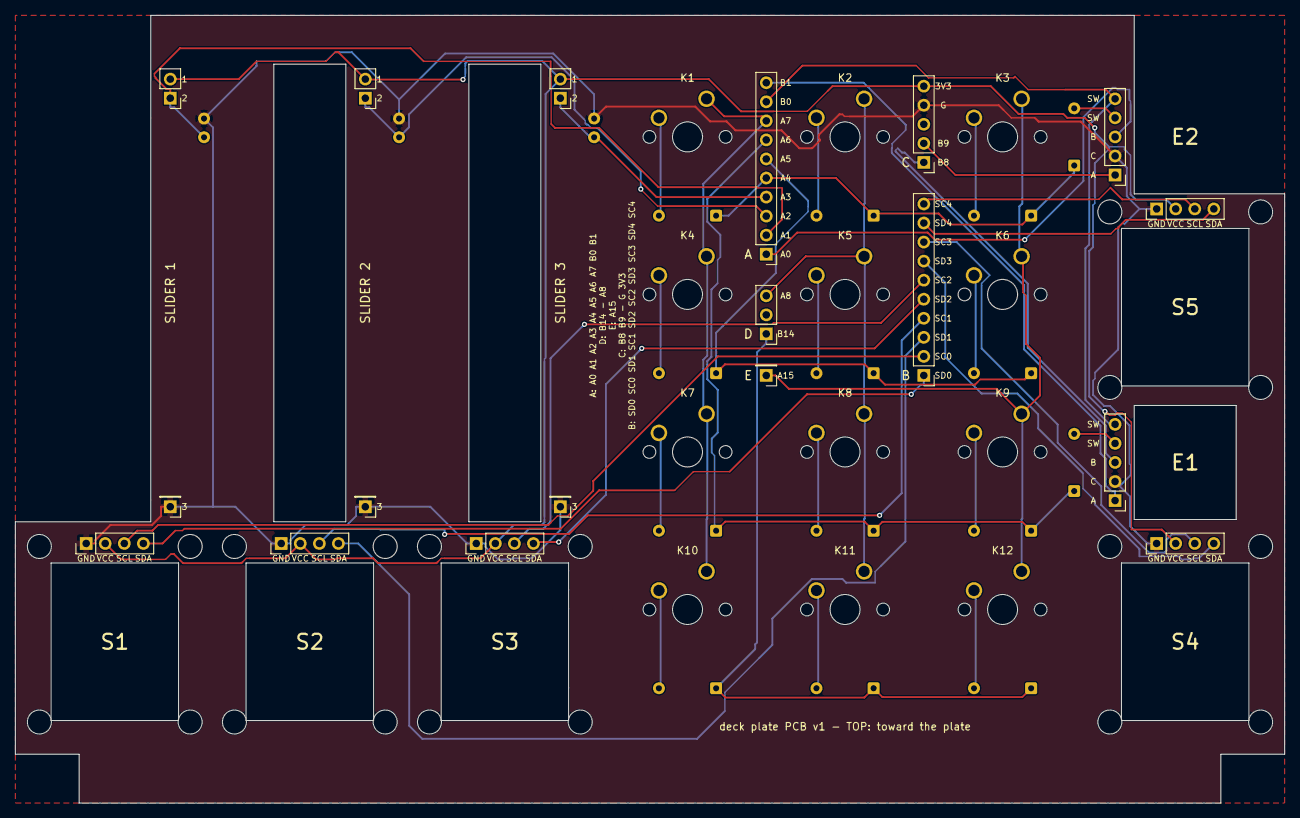
[picture p65: board deck.kicad_pcb from above]

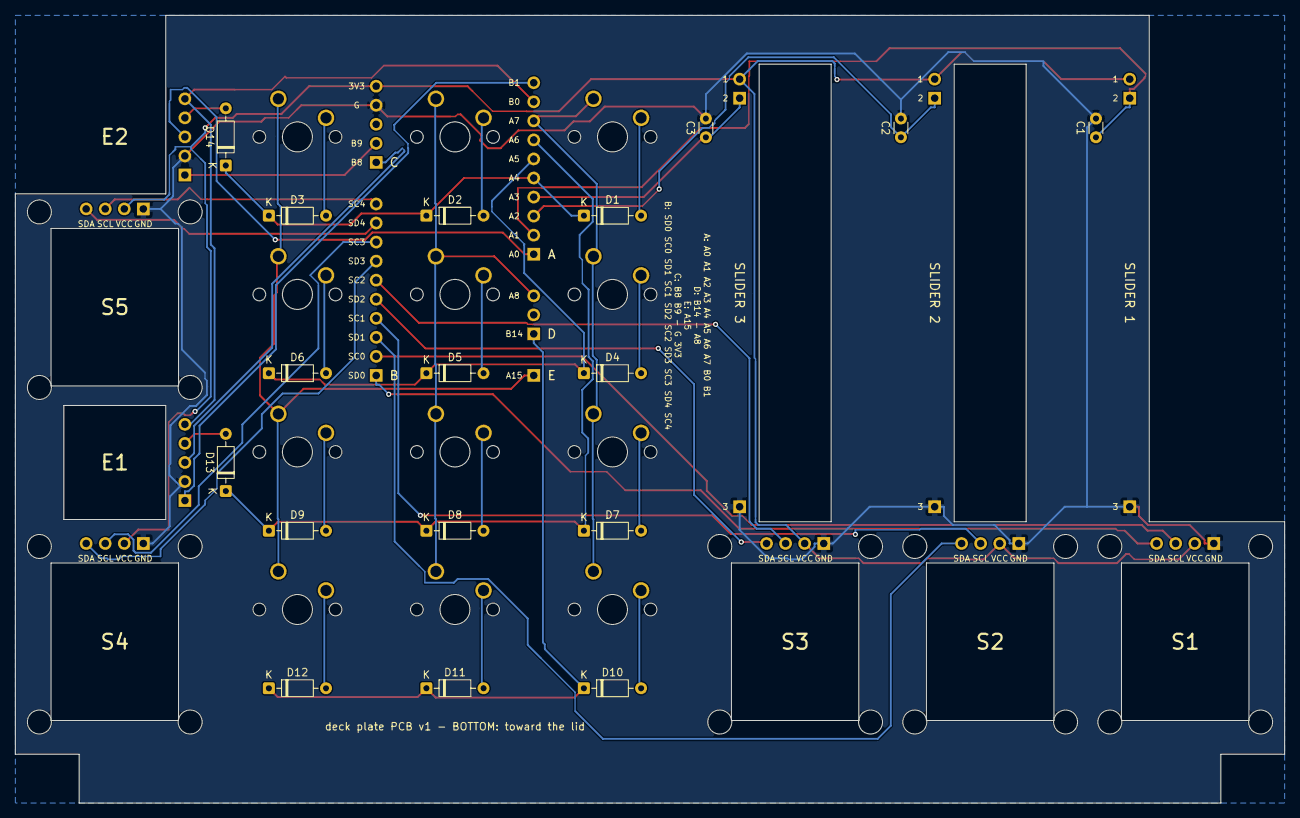
[picture p66: board deck.kicad_pcb from below]

Board: 2 copper layers, 169.2 x 105.0 mm, 67 parts (17 on the bottom side), 41 nets.

Parts:
C1, C2, C3: 100n; C_Disc_D3.0mm_W1.6mm_P2.50mm
D1, D2, D3, D4, D5, D6, D7, D8, D9, D10, D11, D12, D13, D14: 1N4148; D_DO-35_SOD27_P7.62mm_Horizontal
H1LB, H1LF, H1RB, H1RF, H2LB, H2LF, H2RB, H2RF, H3LB, H3LF, H3RB, H3RF, H4LB, H4LF, H4RB, H4RF, H5LB, H5LF, H5RB, H5RF: peg; PegHole_3.2mm
JA: PinHeader_1x10_P2.54mm_Vertical
JB: PinHeader_1x10_P2.54mm_Vertical
JC: PinHeader_1x05_P2.54mm_Vertical
JD: PinHeader_1x03_P2.54mm_Vertical
JE: PinHeader_1x01_P2.54mm_Vertical
J_E1, J_E2: PinHeader_1x05_P2.54mm_Vertical
J_P1, J_P2, J_P3: PinHeader_1x02_P2.54mm_Vertical
J_P1G, J_P2G, J_P3G: PinHeader_1x01_P2.54mm_Vertical
K1, K2, K3, K4, K5, K6, K7, K8, K9, K10, K11, K12: MX; SW_Cherry_MX_1.00u_PCB
S1, S2, S3, S4, S5: PinHeader_1x04_P2.54mm_Vertical

Connections:
3V3: JC.5, J_P1.2, J_P2.2, J_P3.2, S1.2, S2.2, S3.2, S4.2, S5.2
COL0: JA.8, K1.1, K4.1, K7.1, K10.1
COL1: JD.3, K2.1, K5.1, K8.1, K11.1
COL2: JE.1, K3.1, K6.1, K9.1, K12.1
COL3: JA.9, J_E1.5, J_E2.5
E1A: JA.10, J_E1.1
E1B: JC.1, J_E1.3
E1P: D13.2, J_E1.4
E2A: JC.2, J_E2.1
E2B: JA.1, J_E2.3
E2P: D14.2, J_E2.4
GND: C1.2, C2.2, C3.2, JC.4, J_E1.2, J_E2.2, J_P1G.1, J_P2G.1, J_P3G.1, S1.1, S2.1, S3.1, S4.1, S5.1
K1D: D1.2, K1.2
K2D: D2.2, K2.2
K3D: D3.2, K3.2
K4D: D4.2, K4.2
K5D: D5.2, K5.2
K6D: D6.2, K6.2
K7D: D7.2, K7.2
K8D: D8.2, K8.2
K9D: D9.2, K9.2
K10D: D10.2, K10.2
K11D: D11.2, K11.2
K12D: D12.2, K12.2
POT1: C1.1, JA.2, J_P1.1
POT2: C2.1, JA.3, J_P2.1
POT3: C3.1, JA.4, J_P3.1
ROW0: D1.1, D2.1, D3.1, D14.1, JA.5
ROW1: D4.1, D5.1, D6.1, JA.6
ROW2: D7.1, D8.1, D9.1, D13.1, JA.7
ROW3: D10.1, D11.1, D12.1, JD.1
SC0: JB.2, S1.3
SC1: JB.4, S2.3
SC2: JB.6, S3.3
SC3: JB.8, S4.3
SC4: JB.10, S5.3
SD0: JB.1, S1.4
SD1: JB.3, S2.4
SD2: JB.5, S3.4
SD3: JB.7, S4.4
SD4: JB.9, S5.4
